BehrensG/ETH1CSMU1/doc/SMU_BOM.xls

Sheet: MBoard
RefDes | Value | Name | Manufacturer | MPN | Qty | $ | $ | Notes
C1, C6, C7 | 47uf 25V | CAPAE_6.6x6.6h5.7 | Panasonic | EEE-1EA470SP | 3 | $0.25 | $0.75
C2, C3, C4, C8, C12, C13, | 4.7u 25V | CAP_0805 |  |  | 6 | $0.10 | $0.60
C9 | 4.7u 25V 4mm |  |  | UWX1E4R7MCL1GB | 1 |  |  | High ESR: Reversed!
C5 | .01 1206 HiV | CAP_1206 |  | C1206X103MCRAC7800 | 1 | $1.00 | $1.00
C10, C18, C19, C20, C25, C27 | 1000p | CAP_0805 |  |  | 6 | $0.05 | $0.30
C11, C14, C15, C16, C17, C21, C22, C23, C24, C29, C30, C31, C32, C33, C35, C36, C37, C43, C44, C45, C46, C47, C49, C50, C52 | .1u 50V | CAP_0805 |  |  | 25 | $0.02 | $0.50
C26, C28, C34 | 15p | CAP_0805 |  |  | 3 | $0.10 | $0.30
C38 | 100p | CAP_0805 |  |  | 1 | $0.10 | $0.10
C39, C40, C41 | 270p COG | CAP_0805 |  |  | 3 | $0.10 | $0.30
C53 C54 | 270p COG 500V | CAP_1206 |  | CL31C271JGFNNNE | 2 | $0.10 | $0.20
C48 | 150p | CAP_0805 |  |  | 1 | $0.10 | $0.10
C51, C42 | 22p 100V | CAP_0805 |  |  | 1 | $0.10 | $0.10
C55 DNI | 22p 500V | CAP_1206 | Yageo | CC1206JRNPOBBN220 | 1 | $0.10 | $0.10
D1, D2 |  | BAV99 100V 215mA SOT23 | ON | BAV99LT1 | 2 | $0.10 | $0.20
D3, D5, D6, D7 |  | BAV199 SOT23 | Nexperia | BAV199.215 | 4 | $0.10 | $0.40
D4 |  | BAV170 SOT23 | Diodes | BAV170Q | 1 | $0.10 | $0.10
J1 | 14 pin box Hdr | HDRF-2x7 | On Shore Technology | 302-S141 (https://www.digikey.com/product-detail/en/on-shore-technology-inc/302-S141/ED10522-ND/2794233) | 1 | $0.50 | $0.50
J2 | 6p .1" Hdr |  | Molex KK | WM2704-ND‎ | 1 | $1.00 | $1.00
J3 | 6p .15" M |  | On Shore Technology | OSTOQ063251 (https://www.digikey.com/product-detail/en/on-shore-technology-inc/OSTOQ063251/ED2812-ND/1588129) | 1 | $1.00 | $1.00
J4 | 3p .15" M |  | On Shore Technology | OSTOQ033251 (https://www.digikey.com/product-detail/en/on-shore-technology-inc/OSTOQ063251/ED2812-ND/1588129) | 1 | $0.50 | $0.50
K2 | 1.5 ohm SW | AQY221R | Panasonic |  | 1 | $4.00 | $4.00 | 100mA range
K3 | 8 ohm SW | TLP170D | Toshiba |  | 1 | $1.50 | $1.50 | 400V 8 ohms
K1 DNI | Low ohm SW |  |  |  | 0 | $1.66 | $0.00 | For 1A range
K6 | .8 ohm SW | CPC1018N | IXYS |  | 1 | $2.00 | $2.00 | For 1.5V range
K4, K5 |  | RELAY2_DPDT | Kemet | EC2-5NU | 2 | $1.50 | $3.00 | 200V 2A DPDT
L1 | 100uH CM Choke | SRF1260A | Bourns | DR331-105 | 1 | $0.80 | $0.80
Q1, Q2 |  | MMBT3904 | Philips-NXP |  | 2 | $0.10 | $0.20
R4, R5, R9, R11, R12, R13, R15, R16, R18, R19, R20, R21, R22, R23, R24, R25, R26, R54 | 10K .1% | RES_0805 |  |  | 18 | $0.10 | $1.80
R51, R52, R53, R55 | 10K .01% | RES_0805 |  |  | 4 | $0.50 | $2.00 | R53-R51 and R55-R52 0.01% matched
R1, R2, R3, R28, R33, R48, R49, R60, R61, R66 | 10K 1% | RES_0805 |  |  | 10 | $0.02 | $0.20
R68 | 10K 1206 | RES_1206 |  |  | 1 | $0.05 | $0.05
R31 | 20K .1% | RES_0805 |  |  | 1 | $0.10 | $0.10
R29, R34 | 20K 1% | RES_0805 |  |  | 2 | $0.02 | $0.04
R10, R14, R17 | 21.5K .1% | RES_0805 |  |  | 3 | $0.02 | $0.06
R64, R6, R8 | 22.1K .1% | RES_0805 |  |  | 3 | $0.02 | $0.06
place holder for increased DAC ranges | 20.5K .1% | RES_0805 |  |  | 0 | $0.02 | $0.00
R7 | 10K DNI | RES_0805 |  |  | 0 | $0.02 | $0.00
R30, R63, R67 | 4.99K 1% | RES_0805 |  |  | 3 | $0.02 | $0.06
R44 | 4.99K .1% | RES_0805 |  |  | 1 | $0.20 | $0.20
R35 | 200K 1206 | RES_0805 |  |  | 1 | $0.05 | $0.05
R27, R36, R37, R57, R62, R69, R70 | 2K 1% | RES_0805 |  |  | 7 | $0.02 | $0.14
R38, R39 | 2 ohm 1W (DNI) | RES_2512 |  |  | 0 | $0.40 | $0.00
R40, R41 | 100 .1% 1W | RES_2512 |  | RNCF2512TKY100R | 2 | $2.00 | $4.00 | 5ppm .01%
R42 | 499 .1% .25W | RES_1206 |  |  | 1 | $0.50 | $0.50
R43 | 5M 25ppm 1206 | RG3216P-5004-B-T1 (https://www.digikey.com/product-detail/en/susumu/RG3216P-5004-B-T1/408-2038-1-ND/7035421) | Susumu |  | 1 | $0.60 | $0.60
R45 | 49.9K .1% | RES_0805 |  |  | 1 | $0.20 | $0.20
R46 | 549K .1% | RES_0805 |  |  | 1 | $0.20 | $0.20 | 562K is OK
R47, R50, R56, R59 | 100K .1% | RES_0805 |  |  | 4 | $0.10 | $0.40
R58 | 1K | RES_0805 |  |  | 1 | $0.02 | $0.02
R65 | 301K .1% 1206 | RES_1206 |  |  | 1 | $0.40 | $0.40
TP1, TP2, TP3, TP4, TP5 | DNI | TESTPOINT |  |  | 5 | $0.00 | $0.00
U1 | DPBW03F | 3W_DC-DC | MeanWell | DPBW03F | 1 | $10.00 | $10.00
U2 | LM1117 5V | SOT223 | ON Semi | NCP1117LPST50T3G | 1 | $0.50 | $0.50 | many other 1117's
U3 | Si8661AB | Si8661AB-B-IS1 | Silicon Labs | Si8661BB | 1 | $2.50 | $2.50 | Watch default state
U4 |  | TLC2272A | TI | TLC2272AIDR | 1 | $1.50 | $1.50
U5 |  | ADR431BRZ | Analog Devices | ADR431BRZ | 1 | $9.50 | $9.50 | 3ppm, .04%
U6 |  | AT25160B_SOIC8 | Atmel | AT25160B_SOIC8 | 0 | $0.50 | $0.00 | Option…
U7 |  | TL072ACD | TI | TL072ACD | 1 | $0.50 | $0.50
U8, U13, U12, U14, U19, U21 |  | OPA2140 | TI | OPA2140 | 6 | $4.40 | $26.40
U9 | Quad 16b dac | AD5686RBRUZ | Analog Devices | AD5686RBRUZ | 1 | $16.00 | $16.00
U10 | S-D ADC | AD7190BRUZ | Analog Devices | AD7190BRUZ | 1 | $10.00 | $10.00
U11, U17, U18 |  | DG444 or DG441DY | AD, Maxim, Renesas | DG444 or DG441DY | 3 | $2.00 | $6.00 | DG441 has no VL
U15, U16 |  | 74HC595D | NXP-Philips | 74HC595D | 2 | $0.60 | $1.20
U20 |  | TL071ACD | TI | TL071ACD | 1 | $0.50 | $0.50
U22, U23 | Single, Low Ib | OPA140 | TI | OPA140 | 2 | $3.00 | $6.00
PCB |  | 3.5 x 8" |  |  | 1 | $10.00 | $10.00
Total |  |  |  |  |  |  | $131.23

Sheet: Amp Board
RefDes | Value | Name | Manufacturer | MPN | Quantity | $ | $ | Notes
C1, C2 | 470UF 200V | .4" LS 1" dia. | Rubycon | 250MXG470MEFCSN25X30 | 2 | $3.50 | $7.00
C3, C5 | 1U 250V film .45 spacing | CAP300 | Pan | ECQ-E2105KB (https://www.digikey.com/product-detail/en/panasonic-electronic-components/ECQ-E2105KB/P10979-ND/295886) | 2 | $1.00 | $2.00 | Wrong lead spacing
C4, C6 | 470U 25V | CAPAE_8.35x8.35h6.2 |  | EMZS250ARA471MHA0G | 2 | $0.70 | $1.40
C8, C9, C10, C11 | 1000p 500V | CAP_1206 |  | CL31B102KGFNFNE | 4 | $0.15 | $0.60
C7, C12 | 2200p 500V | CAP_1206 | Samsung | CL31B222KGFNFNE | 2 | $0.15 | $0.30
D1, D2, D3, D4, D17, D18 |  | 1N4007 |  |  | 6 | $0.10 | $0.60
D5, D6, D9, D10, D11, D12 |  | BAV99LT1 | ON |  | 6 | $0.10 | $0.60
D7, D8 | 15V 5% 1W Zener | 1N4744A |  |  | 2 | $0.15 | $0.30
D9, D10 | LED Red, 5mm TH |  | Lite-On | LTL4223 | 2 | $0.20 | $0.40
J1 | 5.08mm header 5pos |  | OST | OSTOQ055451 OSTOQ055450 | 1 | $1.00 | $1.00 | RA Vertical
J2 | 3.81mm screw terminal, 6pos |  | OST | OSTOQ063251 (https://www.digikey.com/product-detail/en/on-shore-technology-inc/OSTOQ063251/ED2812-ND/1588129) | 1 | $1.00 | $1.00
J3 | 6pos KK Vert male | HDR-1x6 |  | WM2704-ND‎ | 1 | $1.00 | $1.00
Q1, Q2 | N-Fet 200V 5A TO220 | IRL620 | IR | MMBT3904 | 2 | $0.90 | $1.80 | 200V 5A .8ohm 350pF
Q3 | NPN 120V TO220 | TIP41C | ON | MMBT3906 | 1 | $0.60 | $0.60
Q4 | PNP 120V TO220 | TIP42C | ON | PZT2222 | 1 | $0.60 | $0.60
Q5, Q6 | P-Fet 200V 3.5A TO220 | IRF9620 | IR | PZT2907 | 2 | $0.90 | $1.80 | 200V 3.5A 1.5ohm 350pF
Q7 | NPN 40V SOT23 | MMBT3904 |  | MMBT3904 | 1 | $0.10 | $0.10
Q8 | PNP 40V SOT23 | MMBT3906 |  | MMBT3906 | 1 | $0.10 | $0.10
Q9 | NPN 40V SOT223 | PZT2222 |  | PZT2222 | 1 | $0.30 | $0.30
Q10 | PNP 40V SOT223 | PZT2907 |  | PZT2907 | 1 | $0.30 | $0.30
R1, R2 | 30.1 Ohm 5% .5W 1206 | RES_1206 | Yageo | RC1206JR-0730RL | 2 | $0.10 | $0.20
R3, R4, R6, R8 | 2.2M 1206 | RES_1206 | Yageo |  | 4 | $0.10 | $0.40
R5, R7 | 1M 1206 | RES_1206 | Yageo |  | 2 | $0.10 | $0.20
R9, R16 | 25 1W 2512 | RES_2512 | Yageo |  | 2 | $0.10 | $0.20
R10 | 24.9 1% | RES_0805 | Yageo |  | 1 | $0.05 | $0.05
R11, R13 | 1k | RES_0805 | Yageo |  | 2 | $0.05 | $0.10
R12, R17, R19 | 249 1% | RES_0805 | Yageo |  | 2 | $0.05 | $0.10
R20, R21, R22, R23 | 49.9 ohm 1% | RES_0805 | Yageo |  | 4 | $0.05 | $0.20
R18, R32 | 2K 1% 1W 2512 | RES_2512 | Yageo |  | 2 | $0.10 | $0.20
R14, R15 | 1K 5% 1W 2512 | RES_2512 |  |  | 2 | $0.30 | $0.60
PCB Amp Rev2 |  | 7.25 x 1.9" 184.15 x 48.26mm |  |  | 1 | $5.00 | $5.00
 |  |  |  |  |  |  | $29.05

Sheet: System
RefDes | Value | Manufacturer | MPN | Quantity | $ | $ | Notes
T1 | 120V x 2 Med Grade 25-50W Transformer | Talema Triad | 0050MD-1-003 VPM240-100 | 1 | $35.00 | $35.00
HS1 | Heat Sink ~2.5 x 7 x .25" |  |  | 1 | $10.00 | $10.00 | Approx cost. 6 tapped holes
 | TO220 Thermal pads | Chomerics | 60-11-D397-1674 | 6 | $0.50 | $3.00
 | #4 shoulder washers | Keystone | 3102 | 6 | $0.25 | $1.50
 | $4-40 screws, 3/8" SS |  |  | 6 | $0.10 | $0.60
HW | Standoffs… |  |  | 10 | $0.30 | $3.00
Connectors | 5.08mm Term Block Plug 5pos | OST | OSTTJ055153 | 1 | $2.00 | $2.00
 | 3.81 plug screw 3pos | Amphenol | TJ0331530000G | 1 | $0.80 | $0.80
 | 3.81 plug screw 6pos | Amphenol | TJ0631530000G | 2 | $1.20 | $2.40
 | .1" KK 6pos, gold pins | Molex | WM2312-ND | 10 | $0.15 | $1.50
Banana Jacks | Black, Safety type | Cal Test | CT29xx | 2 | $1.50 | $3.00 | - and -sense
Banana Jacks | Red, Safety type | Cal Test | CT29xx | 2 | $1.50 | $3.00 | + and +sense
Banana Jacks | Yellow, Safety type | Cal Test | CT29xx | 1 | $1.50 | $1.50 | Guard
Banana Jacks | Green, Safety type | Cal Test | CT29xx | 1 | $1.50 | $1.50 | Ground
12V 1A PS | 12V Enclosed power supply | MeanWell TDK | RS-15-12 LS25-12 | 1 | $16.00 | $16.00 | Meanwell is cheaper TDK lower noise, $$$
AC In | AC in with fuse, switch and filter | Delta | 06AK2 | 1 | $18.00 | $18.00
AC SW |  |  |  | 1 | $2.00 | $2.00
Enclosure |  |  |  | 1 | $45.00 | $45.00
Fan | 50mm 12V |  |  | 1 | $5.00 | $5.00
Main Board |  |  |  | 1 | $131.23 | $131.23
Amp Board |  |  |  | 1 | $29.05 | $29.05
FP Board | FP Board, Teensy 3.2, TFT, buttons |  |  | 1 | $60.00 | $60.00
Front Panel | PCB? |  |  | 1 | $10.00 | $10.00
Total |  |  |  |  |  | $385.08
