BehrensG/ETH1CSMU1/doc/AmpBoardSch1.pdf

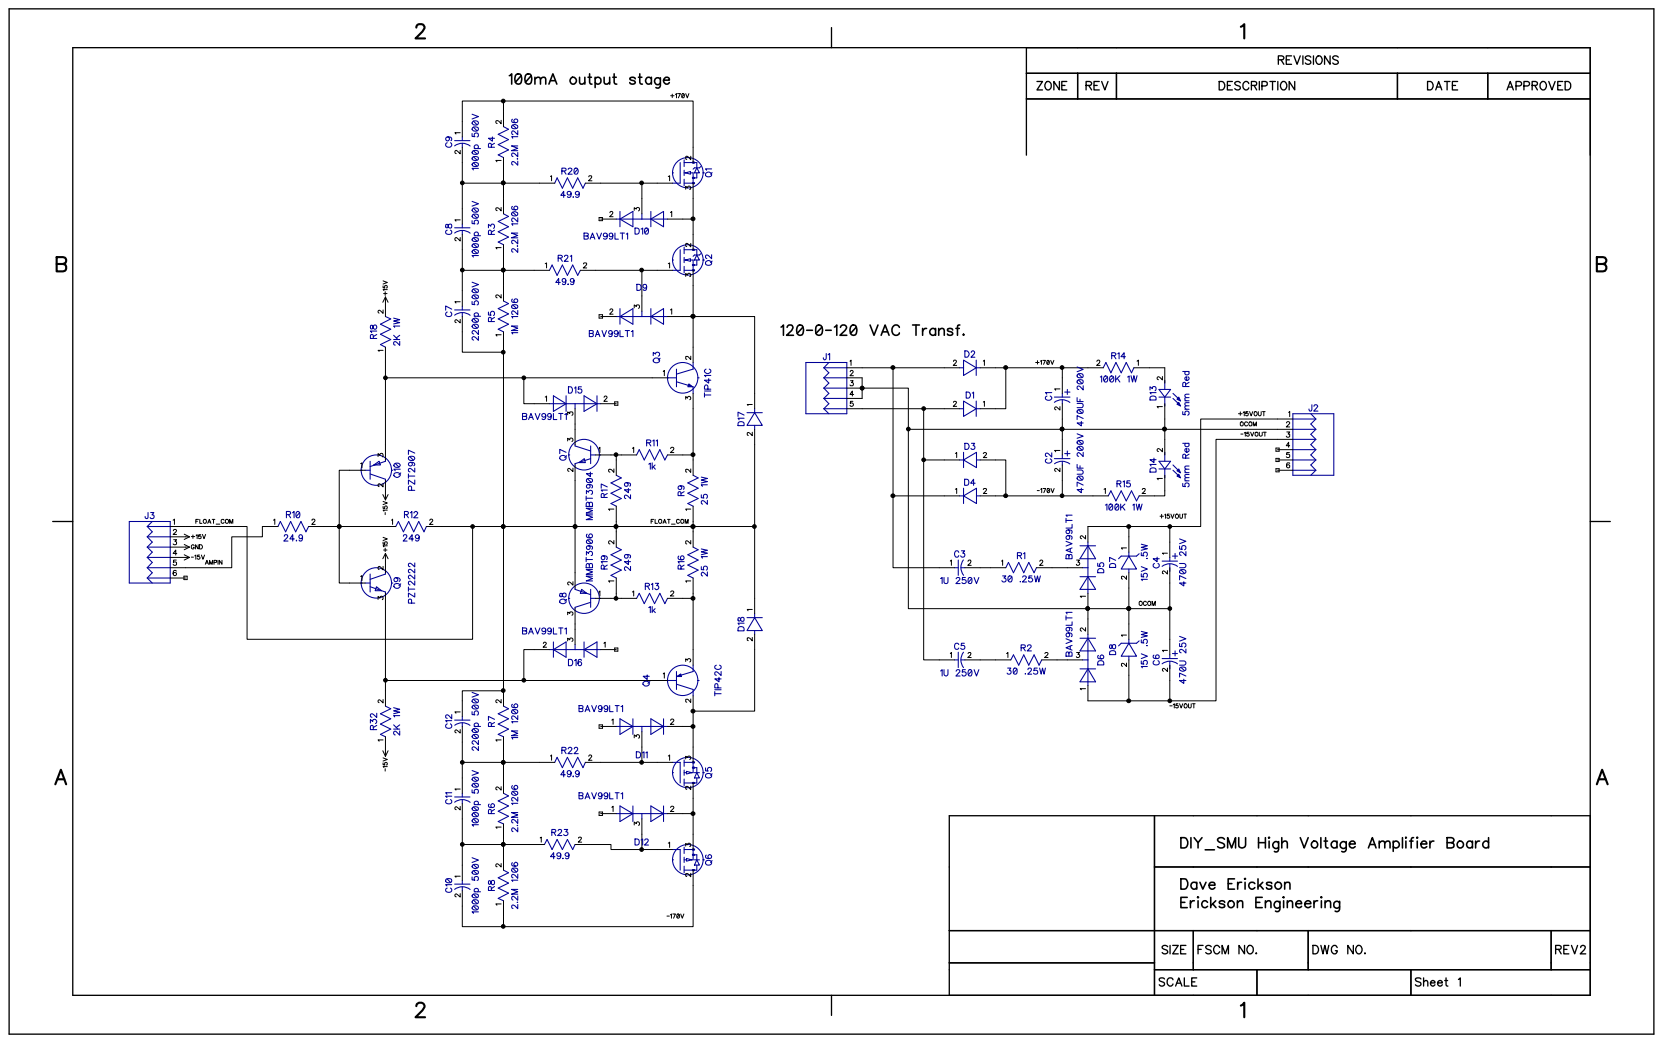
[picture p1: page 1]
