BehrensG/ETH1CSMU1/doc/MainBoardSch1.pdf

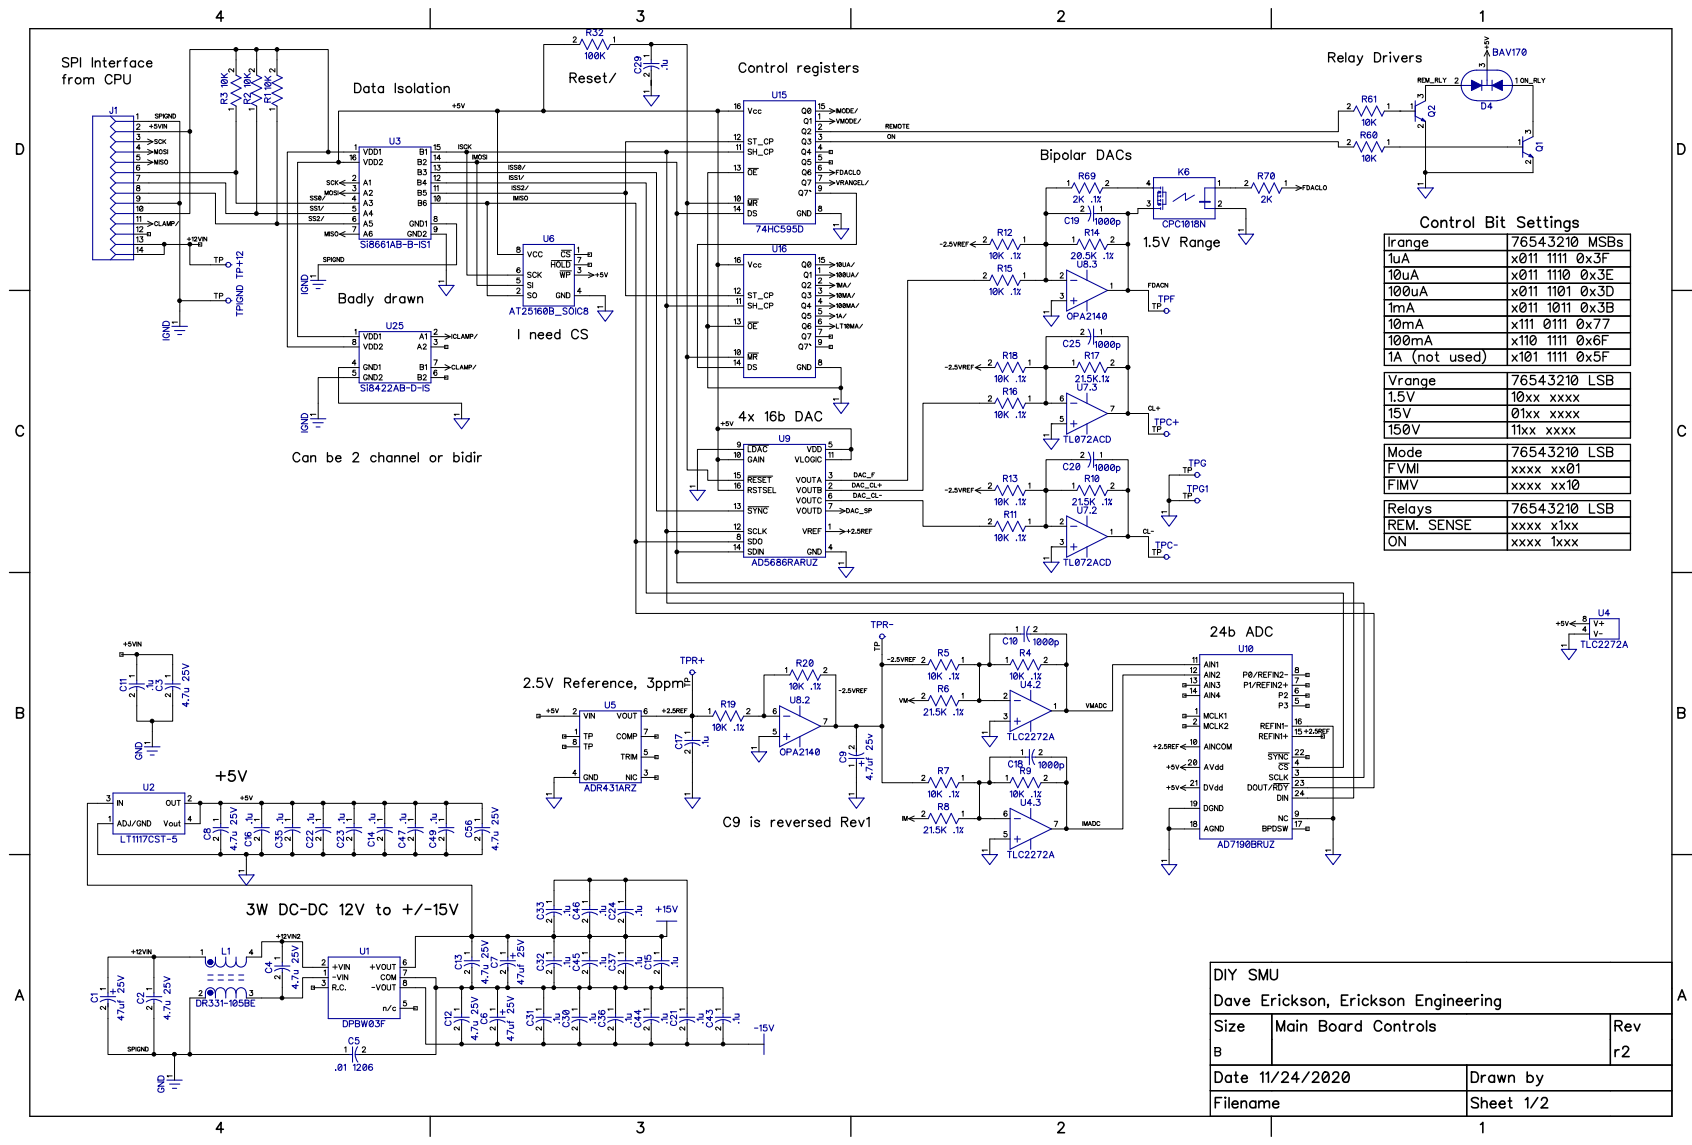
[picture p2: page 1]

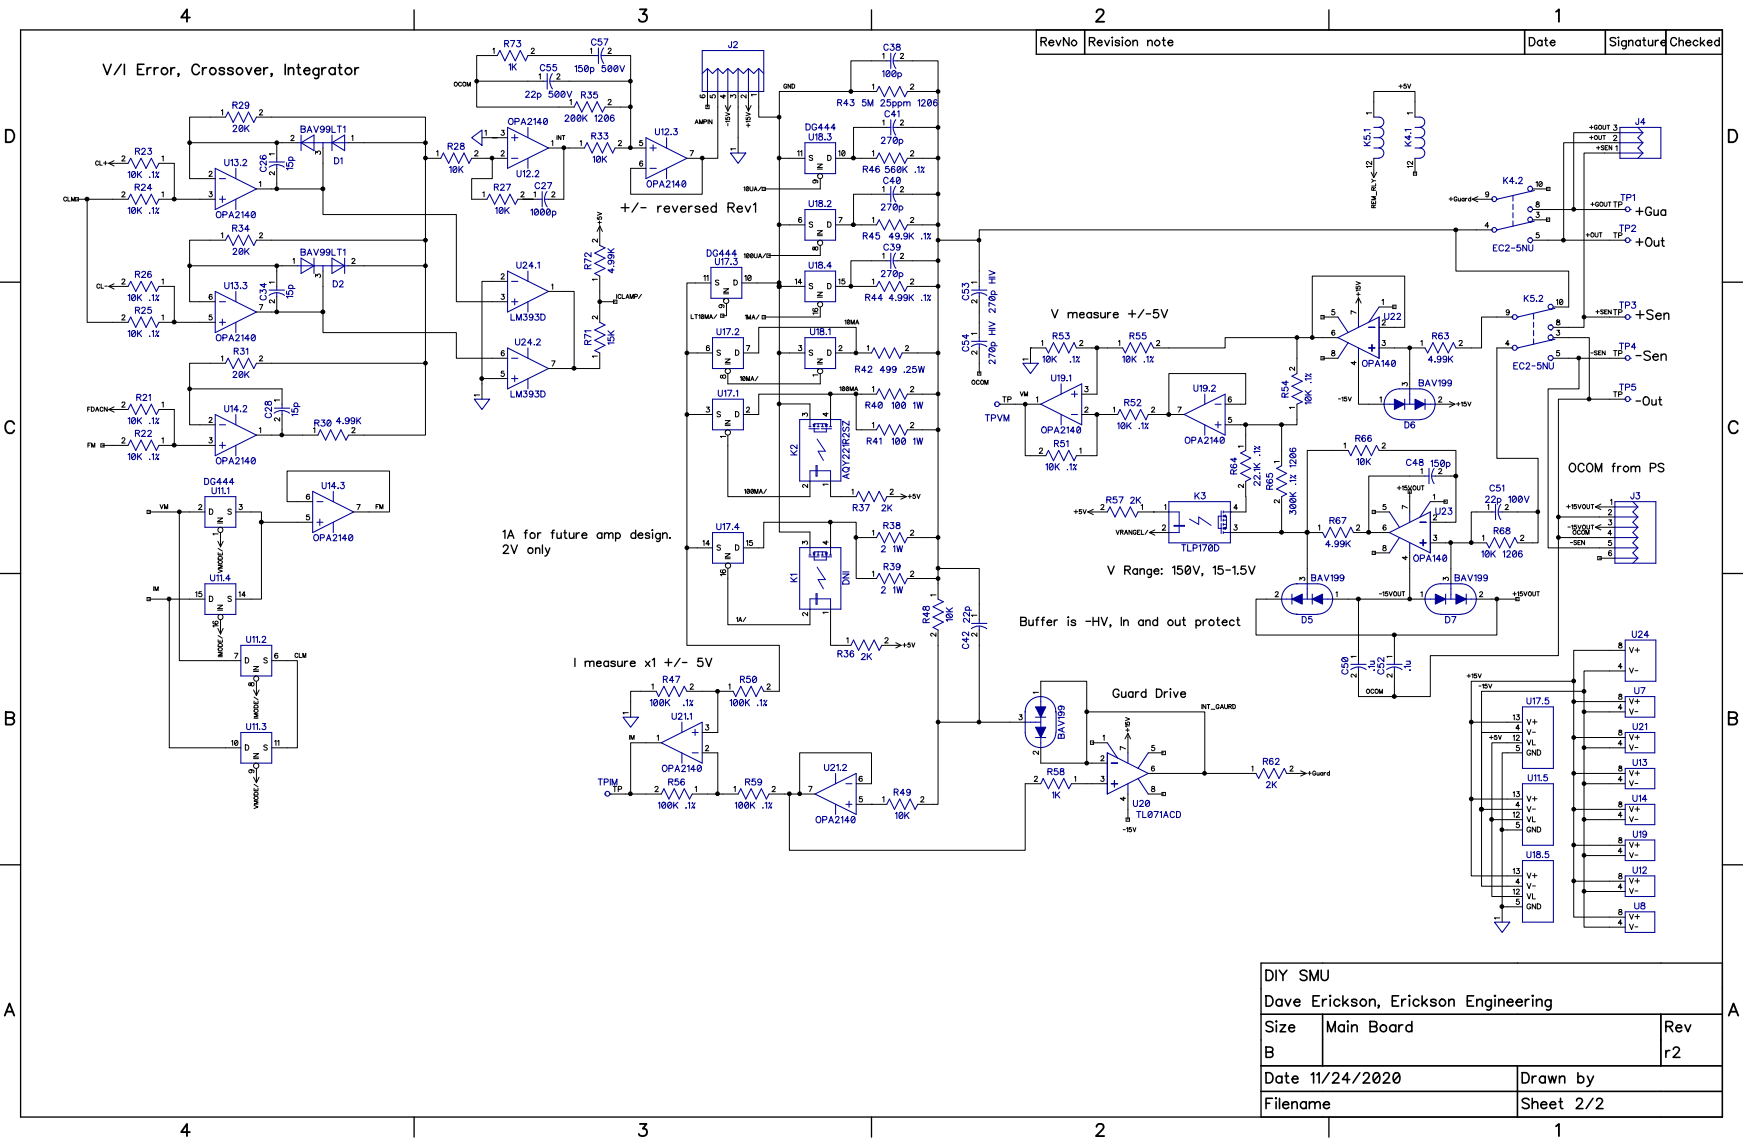
[picture p3: page 2]
