BehrensG/ETH1CSMU1/HARDWARE/MODULE/MODULE.kicad_pcb

## KiCad design HARDWARE/MODULE/MODULE.kicad_pcb (2021-06-25)

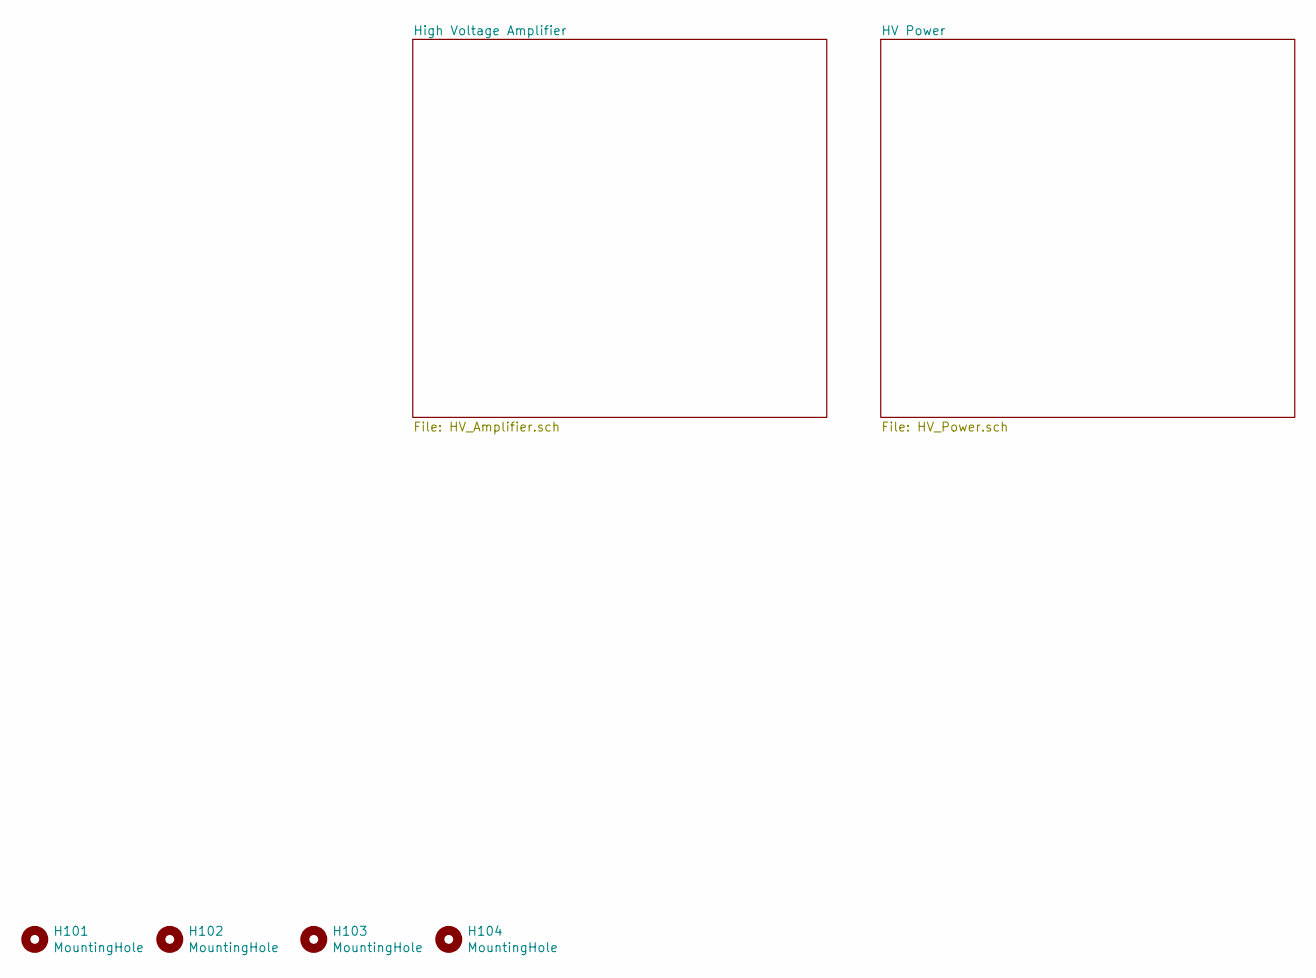
[picture p4: schematic MODULE.sch]

Parts:
H101, H102, H103, H104: MountingHole; MountingHole_3.2mm_M3_DIN965_Pad

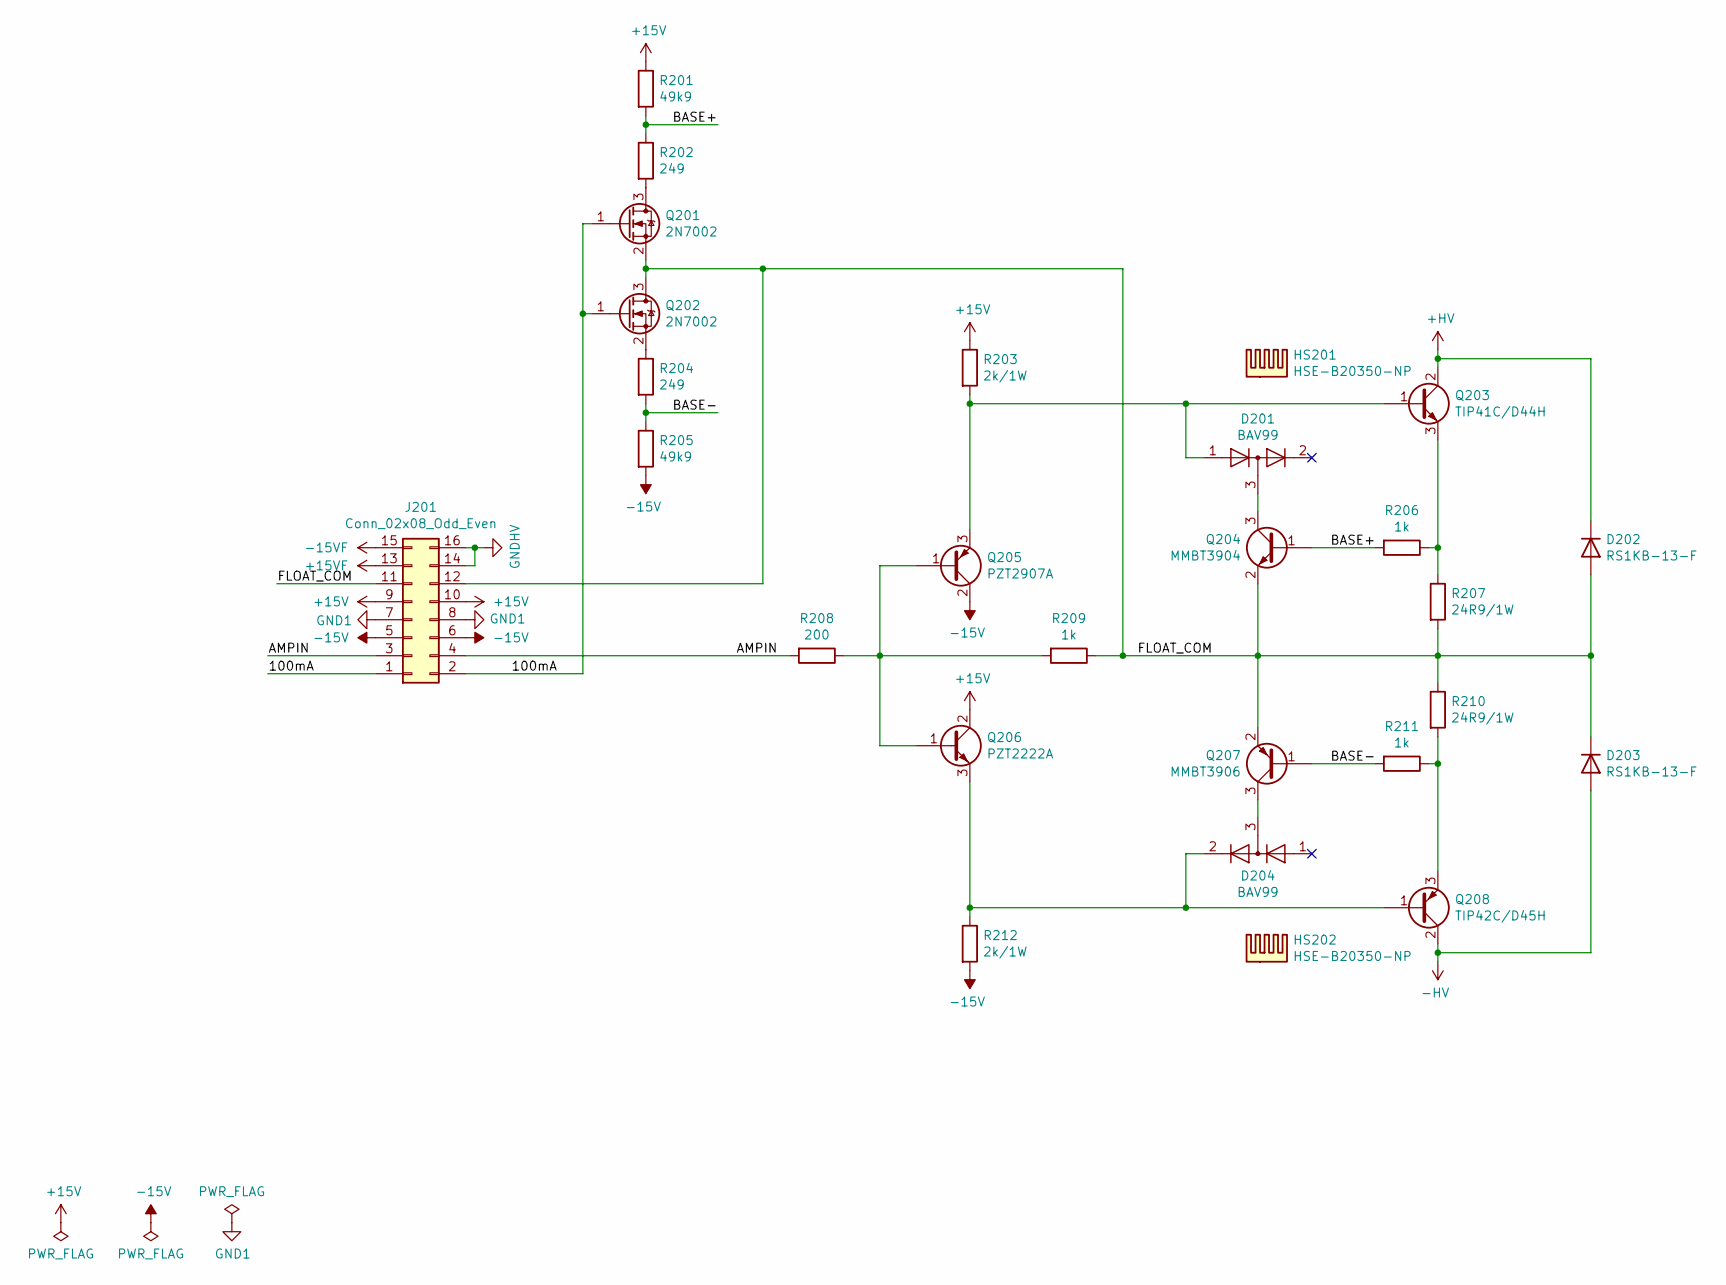
[picture p5: schematic HV_Amplifier.sch]

Parts:
D201, D204: BAV99; SOT-23
D202, D203: RS1KB-13-F; D_SMA
HS201, HS202: HSE-B20350-NP
J201: Conn_02x08_Odd_Even; PinSocket_2x08_P2.54mm_Vertical
Q201, Q202: 2N7002; SOT-23
Q203: TIP41C/D44H; TO-220-3_Horizontal_TabDown
Q204: MMBT3904; SOT-23
Q205: PZT2907A; SOT-223-3_TabPin2
Q206: PZT2222A; SOT-223-3_TabPin2
Q207: MMBT3906; SOT-23
Q208: TIP42C/D45H; TO-220-3_Horizontal_TabDown
R201, R205: 49k9; R_0805_2012Metric_Pad1.20x1.40mm_HandSolder
R202, R204: 249; R_0805_2012Metric_Pad1.20x1.40mm_HandSolder
R203, R212: 2k/1W; R_2512_6332Metric_Pad1.40x3.35mm_HandSolder
R206, R209, R211: 1k; R_0805_2012Metric_Pad1.20x1.40mm_HandSolder
R207, R210: 24R9/1W; R_2512_6332Metric_Pad1.40x3.35mm_HandSolder
R208: 200; R_0805_2012Metric_Pad1.20x1.40mm_HandSolder

Connections:
+15V: J201.9, J201.10, Q206.2 (C), R201.1, R203.1
+15VF: J201.13; also elsewhere on the board
+HV: D202.1 (K), Q203.2 (C); also elsewhere on the board
-15V: J201.5, J201.6, Q205.2 (C), R205.2, R212.2
-15VF: J201.15; also elsewhere on the board
-HV: D203.2 (A), Q208.2 (C); also elsewhere on the board
/High Voltage Amplifier/100mA: J201.1, J201.2, Q201.1 (G), Q202.1 (G)
/High Voltage Amplifier/AMPIN: J201.3, J201.4, R208.2
/High Voltage Amplifier/BASE+: Q204.1 (B), R201.2, R202.1, R206.2
/High Voltage Amplifier/BASE-: Q207.1 (B), R204.2, R205.1, R211.2
/High Voltage Amplifier/FLOAT_COM: D202.2 (A), D203.1 (K), J201.11, J201.12, Q201.2 (S), Q202.3 (D), Q204.2 (E), Q207.2 (E), R207.2, R209.1, R210.1
GND1: J201.7, J201.8
GNDHV: J201.14, J201.16; also elsewhere on the board
unnamed: D201.1 (K), Q203.1 (B), Q205.3 (E), R203.2
unnamed: D201.3 (K), Q204.3 (C)
unnamed: D204.2 (A), Q206.3 (E), Q208.1 (B), R212.1
unnamed: D204.3 (K), Q207.3 (C)
unnamed: Q201.3 (D), R202.2
unnamed: Q202.2 (S), R204.1
unnamed: Q203.3 (E), R206.1, R207.1
unnamed: Q205.1 (B), Q206.1 (B), R208.1, R209.2
unnamed: Q208.3 (E), R210.2, R211.1

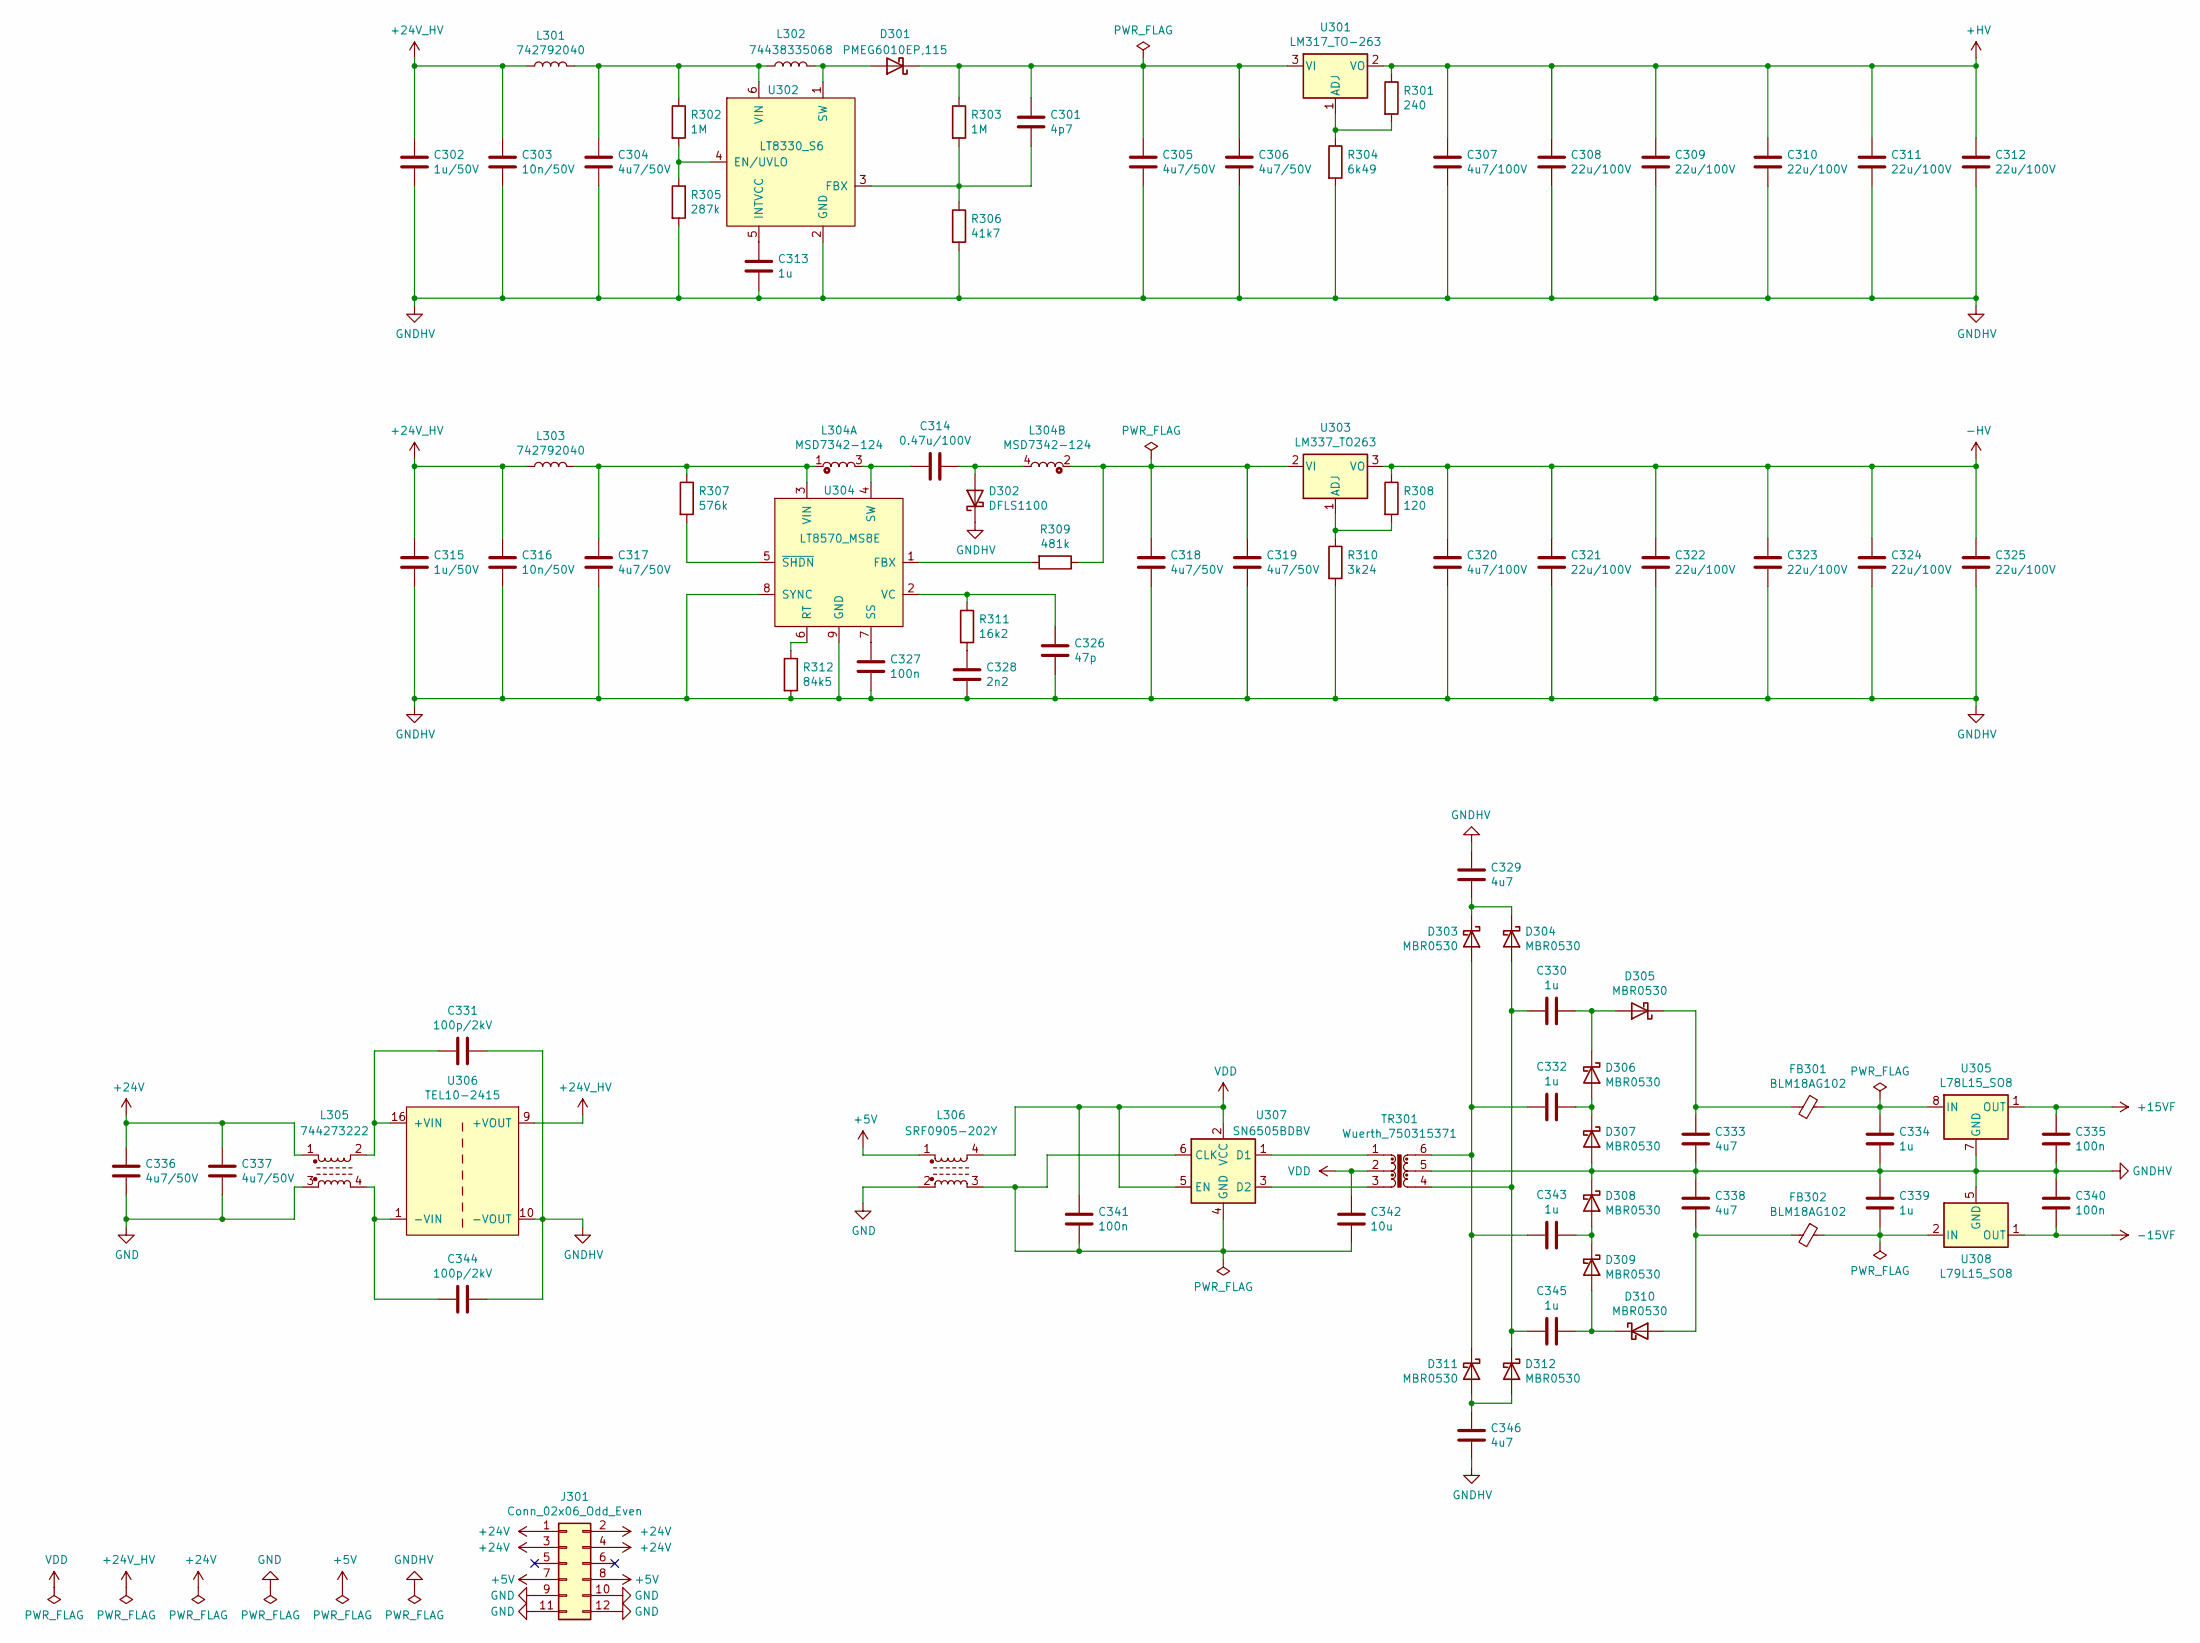
[picture p6: schematic HV_Power.sch]

Parts:
C301: 4p7; C_0603_1608Metric_Pad1.08x0.95mm_HandSolder
C302, C315: 1u/50V; C_1206_3216Metric_Pad1.33x1.80mm_HandSolder
C303, C316: 10n/50V; C_1206_3216Metric_Pad1.33x1.80mm_HandSolder
C304, C305, C306, C317, C318, C319, C336, C337: 4u7/50V; C_1206_3216Metric_Pad1.33x1.80mm_HandSolder
C307, C320: 4u7/100V; C_2220_5650Metric_Pad1.97x5.40mm_HandSolder
C308, C309, C310, C311, C312, C321, C322, C323, C324, C325: 22u/100V; C_2220_5650Metric_Pad1.97x5.40mm_HandSolder
C313, C330, C332, C334, C339, C343, C345: 1u; C_0603_1608Metric_Pad1.08x0.95mm_HandSolder
C314: 0.47u/100V; C_1206_3216Metric_Pad1.33x1.80mm_HandSolder
C326: 47p; C_0603_1608Metric_Pad1.08x0.95mm_HandSolder
C327, C335, C340, C341: 100n; C_0603_1608Metric_Pad1.08x0.95mm_HandSolder
C328: 2n2; C_0603_1608Metric_Pad1.08x0.95mm_HandSolder
C329, C333, C338, C346: 4u7; C_0603_1608Metric_Pad1.08x0.95mm_HandSolder
C331, C344: 100p/2kV; C_1210_3225Metric_Pad1.33x2.70mm_HandSolder
C342: 10u; C_0603_1608Metric_Pad1.08x0.95mm_HandSolder
D301: PMEG6010EP,115; D_SOD-128
D302: DFLS1100; PowerDI-123
D303, D304, D305, D306, D307, D308, D309, D310, D311, D312: MBR0530; D_SOD-123
FB301, FB302: BLM18AG102; L_0603_1608Metric_Pad1.05x0.95mm_HandSolder
J301: Conn_02x06_Odd_Even; PinSocket_2x06_P2.54mm_Vertical
L301, L303: 742792040; L_0805_2012Metric_Pad1.15x1.40mm_HandSolder
L302: 74438335068
L304: MSD7342-124; MSD7342
L305: 744273222
L306: SRF0905-202Y; SRF0905
R301: 240; R_0603_1608Metric_Pad0.98x0.95mm_HandSolder
R302, R303: 1M; R_0603_1608Metric_Pad0.98x0.95mm_HandSolder
R304: 6k49; R_0603_1608Metric_Pad0.98x0.95mm_HandSolder
R305: 287k; R_0603_1608Metric_Pad0.98x0.95mm_HandSolder
R306: 41k7; R_0603_1608Metric_Pad0.98x0.95mm_HandSolder
R307: 576k; R_0603_1608Metric_Pad0.98x0.95mm_HandSolder
R308: 120; R_0603_1608Metric_Pad0.98x0.95mm_HandSolder
R309: 481k; R_0603_1608Metric_Pad0.98x0.95mm_HandSolder
R310: 3k24; R_0603_1608Metric_Pad0.98x0.95mm_HandSolder
R311: 16k2; R_0603_1608Metric_Pad0.98x0.95mm_HandSolder
R312: 84k5; R_0603_1608Metric_Pad0.98x0.95mm_HandSolder
TR301: Wuerth_750315371; Transformer_Wuerth_750315371
U301: LM317_TO-263; TO-263-3_TabPin2
U302: LT8330_S6; TSOT-23-6_HandSoldering
U303: LM337_TO263; TO-263-3_TabPin2
U304: LT8570_MS8E; MSOP-8-1EP_3x3mm_P0.65mm_EP1.68x1.88mm_ThermalVias
U305: L78L15_SO8; SOIC-8_3.9x4.9mm_P1.27mm
U306: TEL10-2415; TEL10
U307: SN6505BDBV; SOT-23-6
U308: L79L15_SO8; SOIC-8_3.9x4.9mm_P1.27mm

Connections:
+5V: J301.7, J301.8, L306.1
+15VF: C335.1, U305.1 (OUT); also elsewhere on the board
+24V: C336.1, C337.1, J301.1, J301.2, J301.3, J301.4, L305.1
+24V_HV: C302.1, C303.1, C315.1, C316.1, L301.1, L303.1, U306.9 (+VOUT)
+HV: C307.1, C308.1, C309.1, C310.1, C311.1, C312.1, R301.1, U301.2 (VO); also elsewhere on the board
-15VF: C340.2, U308.1 (OUT); also elsewhere on the board
-HV: C320.1, C321.1, C322.1, C323.1, C324.1, C325.1, R308.1, U303.3 (VO); also elsewhere on the board
GND: C336.2, C337.2, J301.9, J301.10, J301.11, J301.12, L305.3, L306.2
GNDHV: C302.2, C303.2, C304.2, C305.2, C306.2, C307.2, C308.2, C309.2, C310.2, C311.2, C312.2, C313.2, C315.2, C316.2, C317.2, C318.2, C319.2, C320.2, C321.2, C322.2, C323.2, C324.2, C325.2, C326.2, C327.2, C328.2, C329.1, C331.1, C333.2, C334.2, C335.2, C338.1, C339.1, C340.1, C344.1, C346.2, D302.1 (K), D307.2 (A), D308.1 (K), R304.2, R305.2, R306.2, R310.2, R312.2, TR301.5, U302.2 (GND), U304.8 (SYNC), U304.9 (GND), U305.2 (GND), U305.3 (GND), U305.6 (GND), U305.7 (GND), U306.10 (-VOUT), U308.5 (GND); also elsewhere on the board
unnamed: C301.1, C305.1, C306.1, D301.1 (K), R303.1, U301.3 (VI)
unnamed: C301.2, R303.2, R306.1, U302.3 (FBX)
unnamed: C304.1, L301.2, L302.1, R302.1, U302.6 (VIN)
unnamed: C313.1, U302.5 (INTVCC)
unnamed: C314.1, D302.2 (A), L304.4
unnamed: C314.2, L304.3, U304.4 (SW)
unnamed: C317.1, L303.2, L304.1, R307.1, U304.3 (VIN)
unnamed: C318.1, C319.1, L304.2, R309.1, U303.2 (VI)
unnamed: C326.1, R311.1, U304.2 (VC)
unnamed: C327.1, U304.7 (SS)
unnamed: C328.1, R311.2
unnamed: C329.2, D303.1 (K), D304.1 (K)
unnamed: C330.1, D305.2 (A), D306.1 (K)
unnamed: C330.2, C345.2, D304.2 (A), D312.1 (K), TR301.4
unnamed: C331.2, L305.2, U306.16 (+VIN)
unnamed: C332.1, D306.2 (A), D307.1 (K)
unnamed: C332.2, C343.2, D303.2 (A), D311.1 (K), TR301.6
unnamed: C333.1, D305.1 (K), FB301.2
unnamed: C334.1, FB301.1, U305.8 (IN)
unnamed: C338.2, D310.2 (A), FB302.2
unnamed: C339.2, FB302.1, U308.2 (IN), U308.3 (IN), U308.6 (IN), U308.7 (IN)
unnamed: C341.2, C342.2, L306.3, U307.4 (GND), U307.6 (CLK)
unnamed: C343.1, D308.2 (A), D309.1 (K)
unnamed: C344.2, L305.4, U306.1 (-VIN)
unnamed: C345.1, D309.2 (A), D310.1 (K)
unnamed: C346.1, D311.2 (A), D312.2 (A)
unnamed: D301.2 (A), L302.2, U302.1 (SW)
unnamed: R301.2, R304.1, U301.1 (ADJ)
unnamed: R302.2, R305.1, U302.4 (EN/UVLO)
unnamed: R307.2, U304.5 (~SHDN)
unnamed: R308.2, R310.1, U303.1 (ADJ)
unnamed: R309.2, U304.1 (FBX)
unnamed: R312.1, U304.6 (RT)
unnamed: TR301.1, U307.1 (D1)
unnamed: TR301.3, U307.3 (D2)
VDD: C341.1, C342.1, L306.4, TR301.2, U307.2 (VCC), U307.5 (EN)

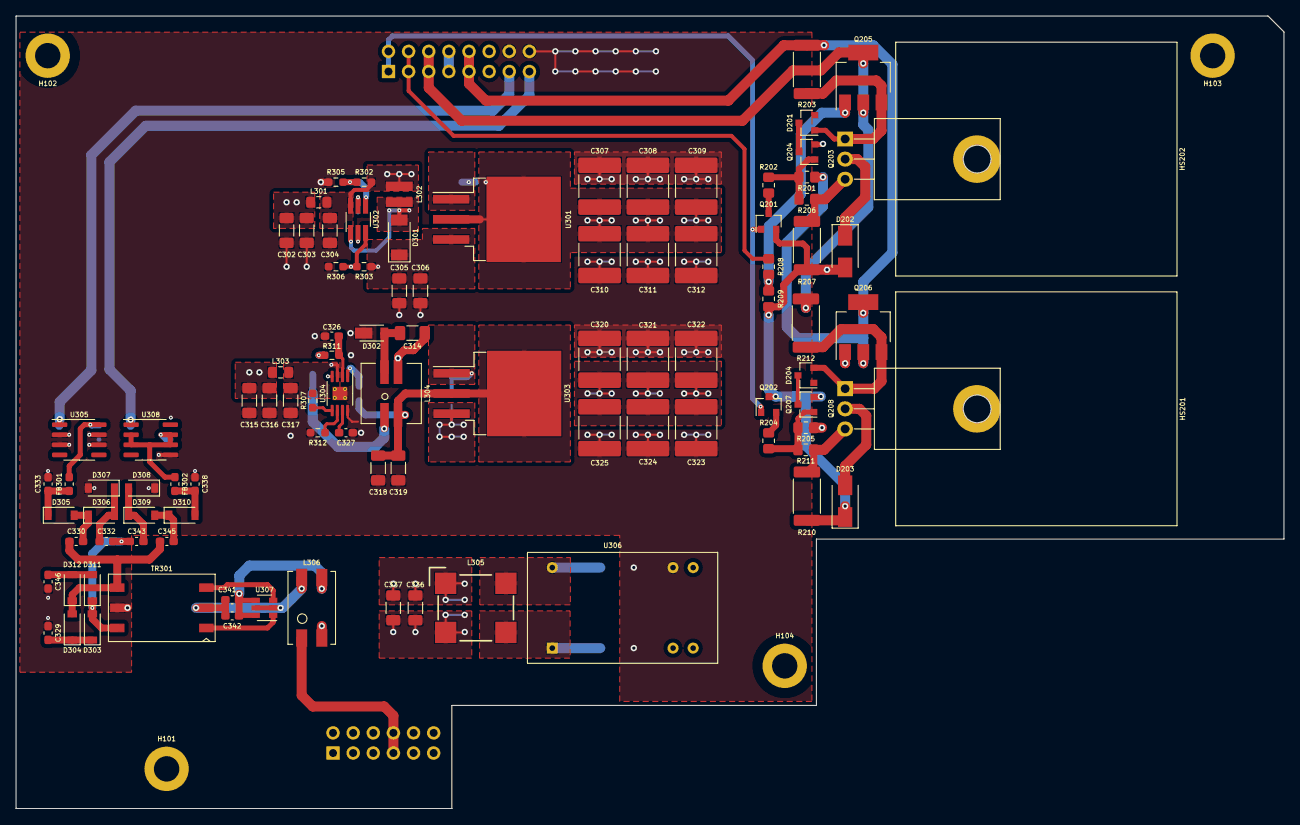
[picture p7: board MODULE.kicad_pcb from above]

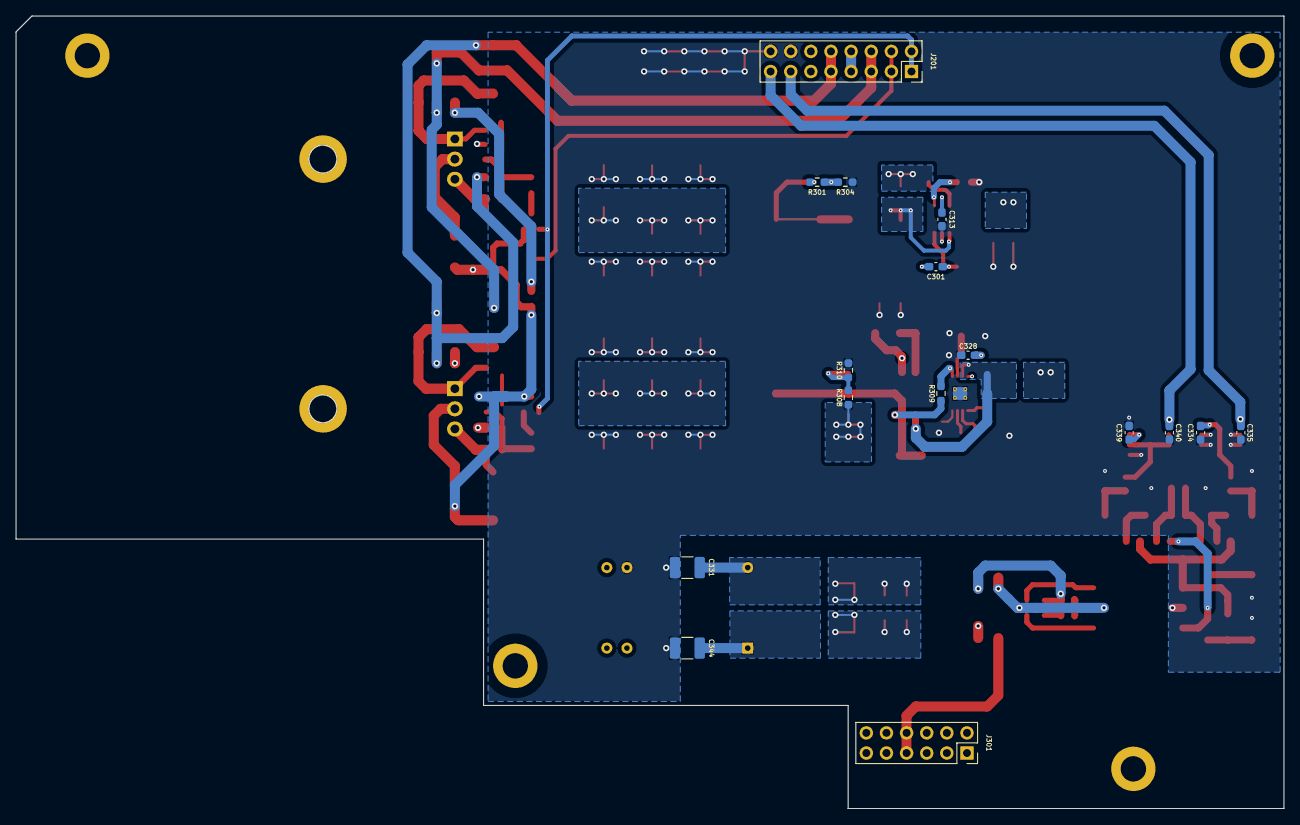
[picture p8: board MODULE.kicad_pcb from below]

Board: 4 copper layers, 160.0 x 100.0 mm, 119 parts (16 on the bottom side), 62 nets.
