BehrensG/ETH1CSMU1/HARDWARE/BASE/BASE.kicad_pcb

## KiCad design HARDWARE/BASE/BASE.kicad_pcb (2021-04-07)

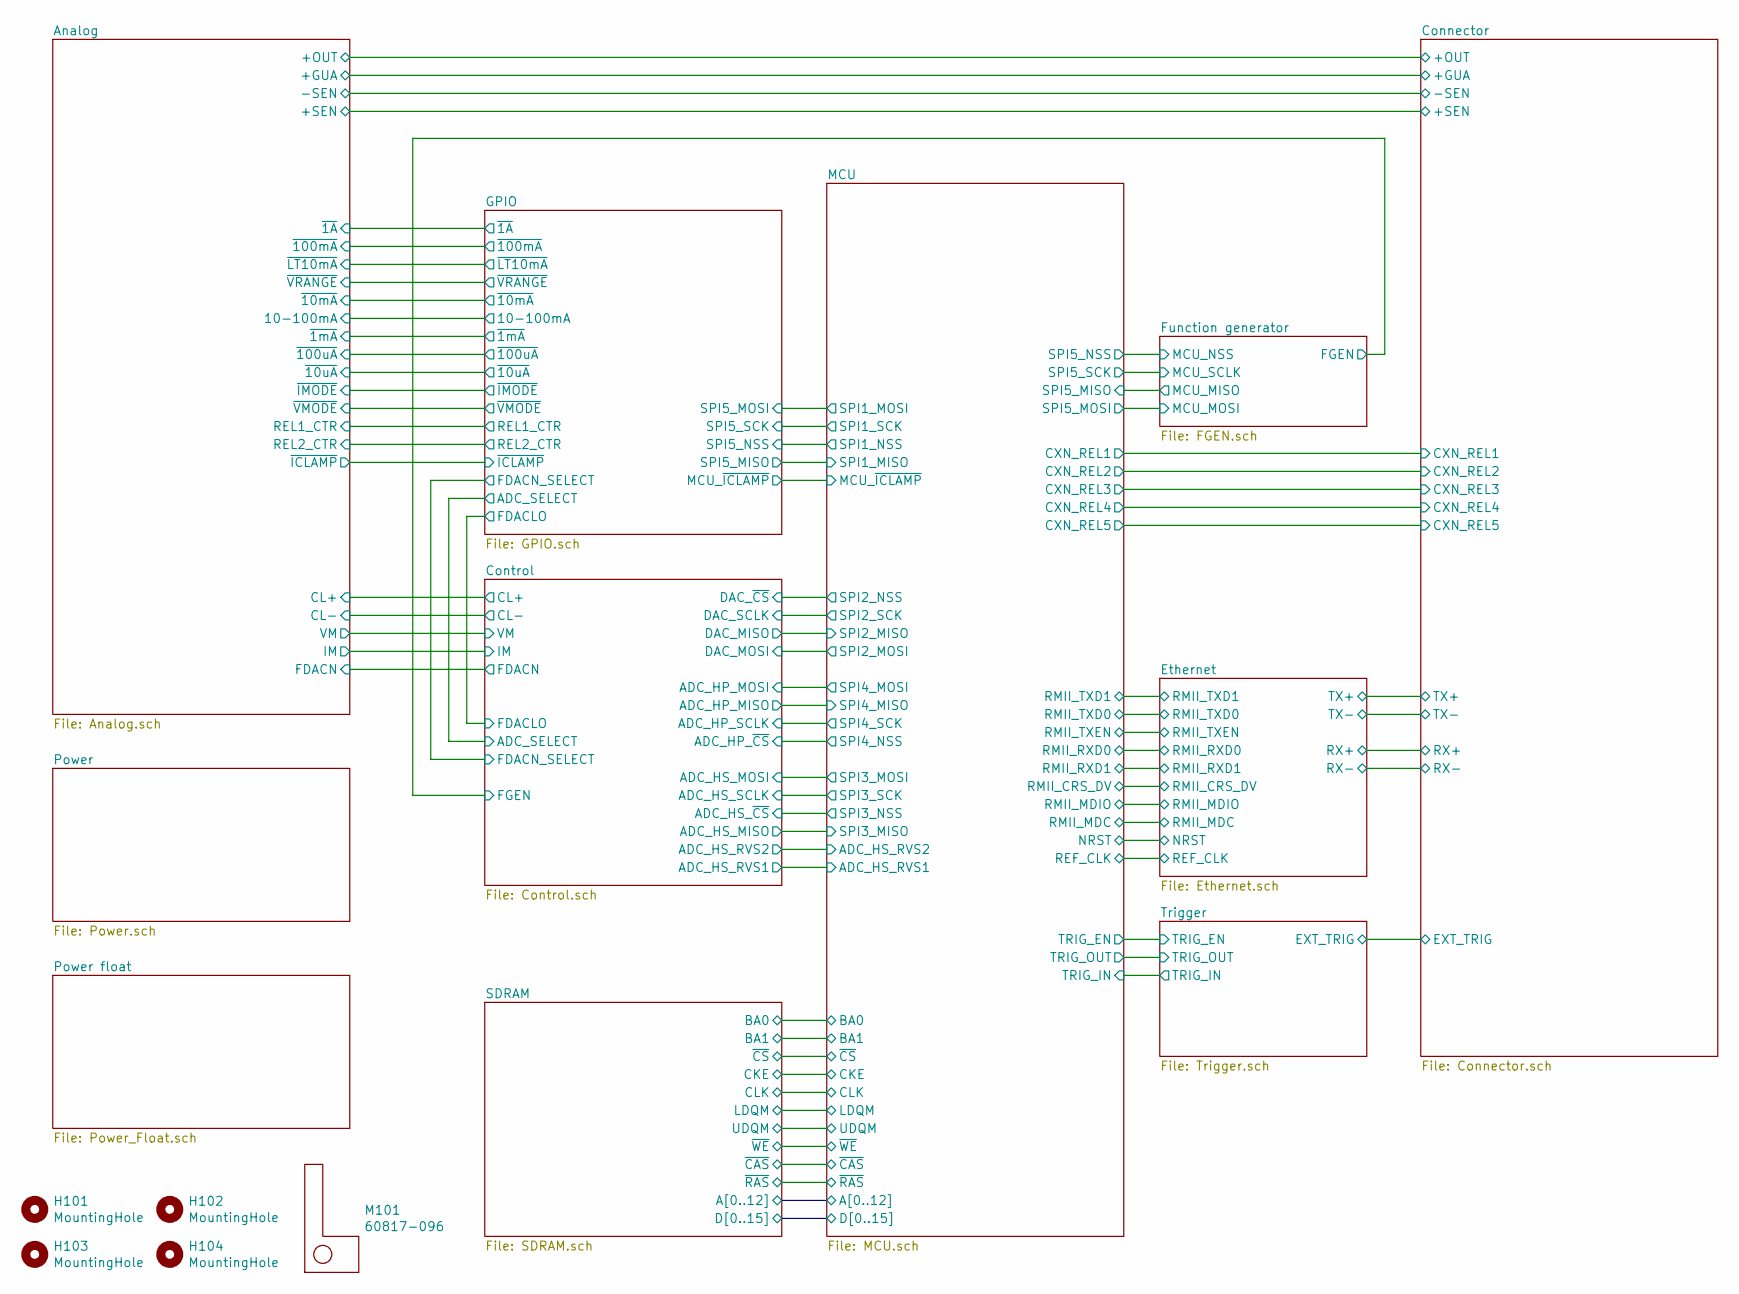
[picture p9: schematic BASE.sch]

Parts:
H101, H102, H103, H104: MountingHole; MountingHole_3.2mm_M3_DIN965_Pad
M101: 60817-096

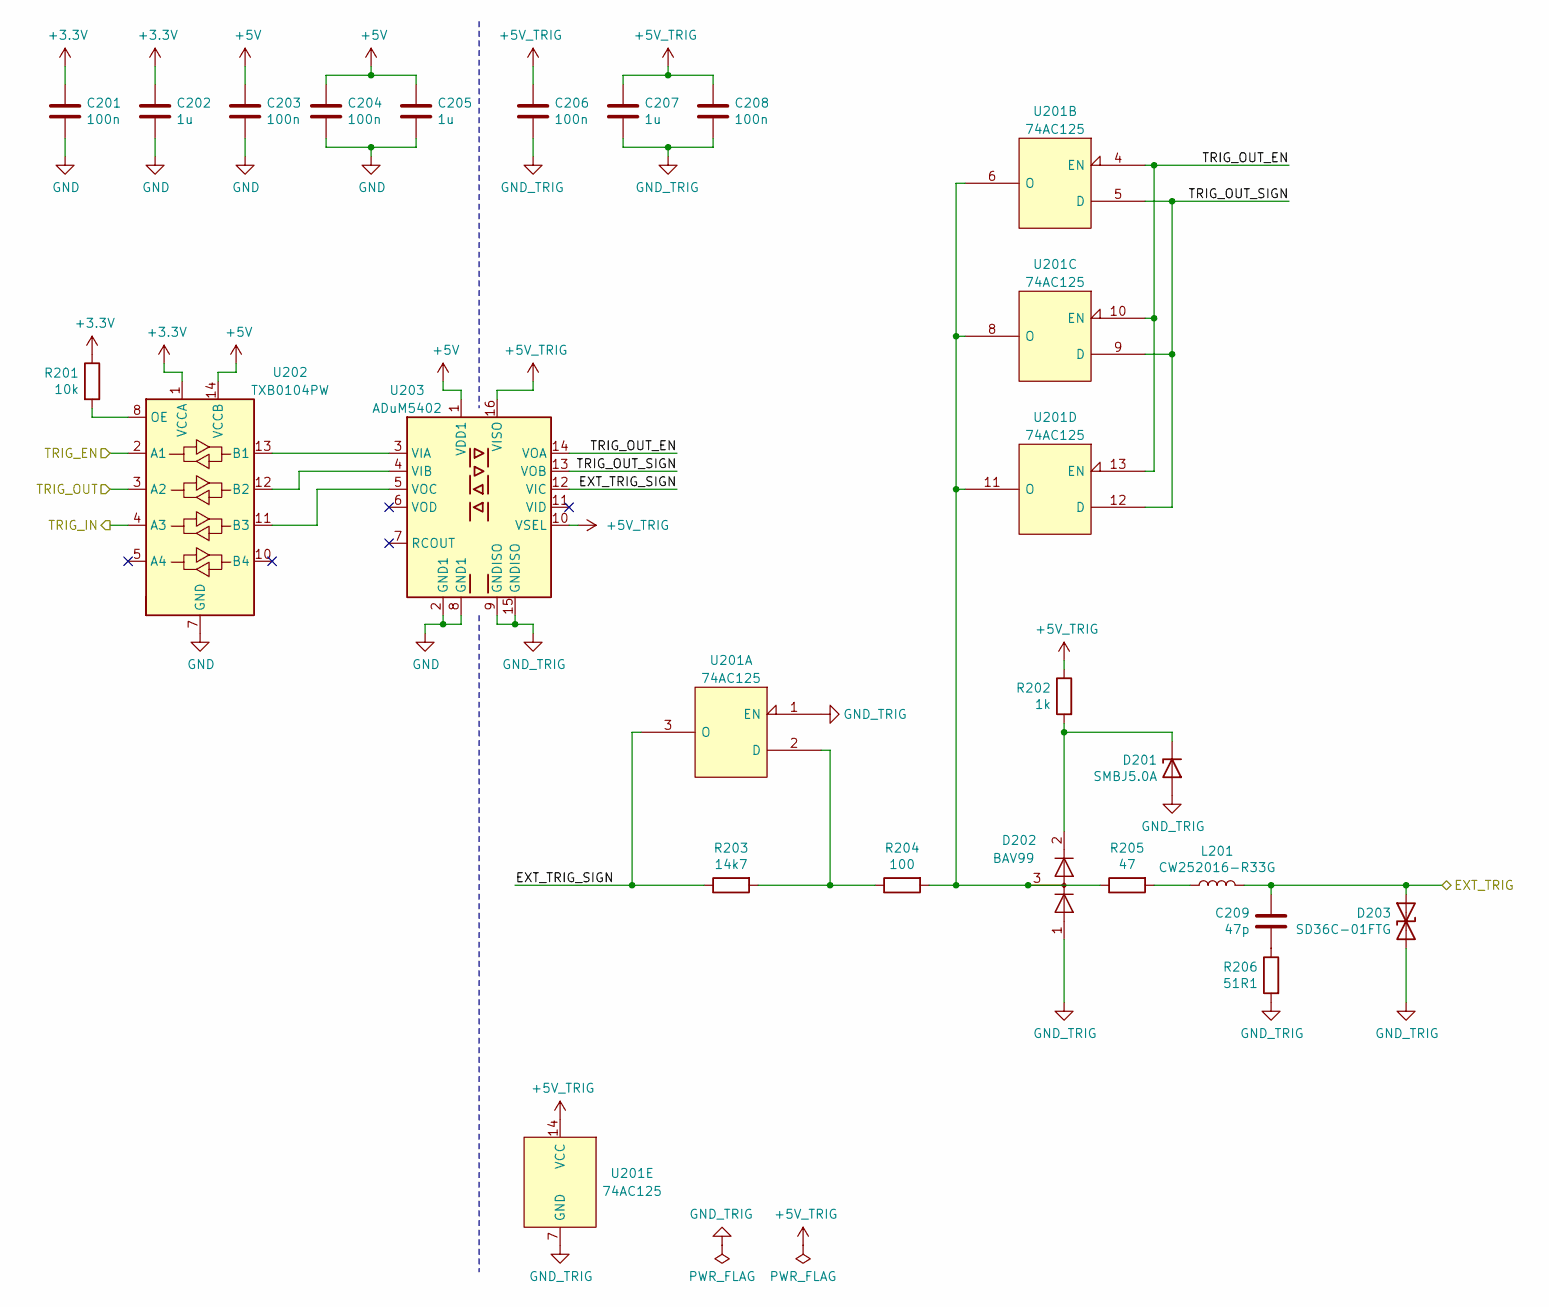
[picture p10: schematic Trigger.sch]

Parts:
C201, C203, C204, C206, C208: 100n; C_0603_1608Metric_Pad1.08x0.95mm_HandSolder
C202, C205, C207: 1u; C_0603_1608Metric_Pad1.08x0.95mm_HandSolder
C209: 47p; C_0603_1608Metric_Pad1.08x0.95mm_HandSolder
D201: SMBJ5.0A; D_SMB
D202: BAV99; SOT-23
D203: SD36C-01FTG; D_SOD-323_HandSoldering
L201: CW252016-R33G; CW252016
R201: 10k; R_0603_1608Metric_Pad0.98x0.95mm_HandSolder
R202: 1k; R_0603_1608Metric_Pad0.98x0.95mm_HandSolder
R203: 14k7; R_0603_1608Metric_Pad0.98x0.95mm_HandSolder
R204: 100; R_0603_1608Metric_Pad0.98x0.95mm_HandSolder
R205: 47; R_0603_1608Metric_Pad0.98x0.95mm_HandSolder
R206: 51R1; R_0603_1608Metric_Pad0.98x0.95mm_HandSolder
U201: 74AC125; TSSOP-14_4.4x5mm_P0.65mm
U202: TXB0104PW; TSSOP-14_4.4x5mm_P0.65mm
U203: ADuM5402; SOIC-16W_7.5x10.3mm_P1.27mm

Connections:
+3V3: C201.1, C202.1, R201.1, U202.1 (VCCA); also elsewhere on the board
+5V: C203.1, C204.1, C205.1, U202.14 (VCCB), U203.1 (VDD1); also elsewhere on the board
+5V_TRIG: C206.1, C207.1, C208.1, R202.1, U201.14 (VCC), U203.10 (VSEL), U203.16 (VISO)
/Connector/EXT_TRIG: C209.1, D203.1 (A1), L201.1; also elsewhere on the board
/MCU/TRIG_EN: U202.2 (A1); also elsewhere on the board
/MCU/TRIG_IN: U202.4 (A3); also elsewhere on the board
/MCU/TRIG_OUT: U202.3 (A2); also elsewhere on the board
/Trigger/EXT_TRIG_SIGN: R203.1, U201.3 (O), U203.12 (VIC)
/Trigger/TRIG_OUT_EN: U201.4 (EN), U201.10 (EN), U201.13 (EN), U203.14 (VOA)
/Trigger/TRIG_OUT_SIGN: U201.5 (D), U201.9 (D), U201.12 (D), U203.13 (VOB)
GND: C201.2, C202.2, C203.2, C204.2, C205.2, U202.7 (GND), U203.2 (GND1), U203.8 (GND1); also elsewhere on the board
GND_TRIG: C206.2, C207.2, C208.2, D201.2 (A), D202.1 (K), D203.2 (A2), R206.2, U201.1 (EN), U201.7 (GND), U203.9 (GNDISO), U203.15 (GNDISO); also elsewhere on the board
unnamed: C209.2, R206.1
unnamed: D201.1 (K), D202.2 (A), R202.2
unnamed: D202.3 (K), R204.2, R205.1, U201.6 (O), U201.8 (O), U201.11 (O)
unnamed: L201.2, R205.2
unnamed: R201.2, U202.8 (OE)
unnamed: R203.2, R204.1, U201.2 (D)
unnamed: U202.11 (B3), U203.5 (VOC)
unnamed: U202.12 (B2), U203.4 (VIB)
unnamed: U202.13 (B1), U203.3 (VIA)

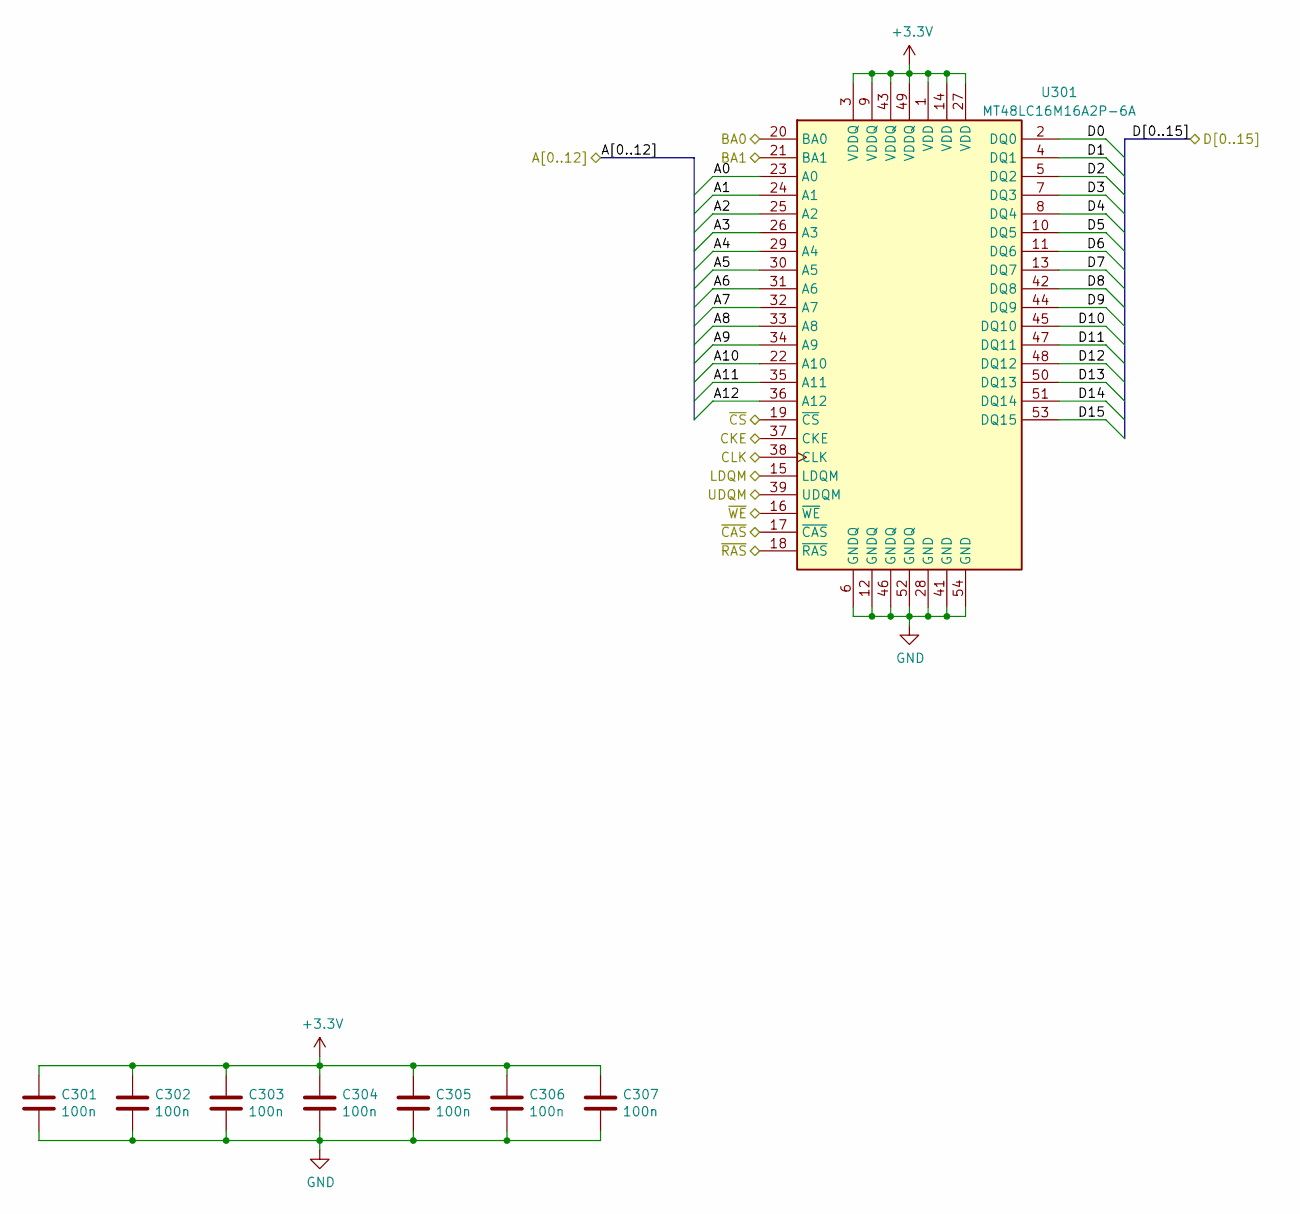
[picture p11: schematic SDRAM.sch]

Parts:
C301, C302, C303, C304, C305, C306, C307: 100n; C_0603_1608Metric_Pad1.08x0.95mm_HandSolder
U301: MT48LC16M16A2P-6A; TSSOP-54

Connections:
+3V3: C301.1, C302.1, C303.1, C304.1, C305.1, C306.1, C307.1, U301.1 (VDD), U301.3 (VDDQ), U301.9 (VDDQ), U301.14 (VDD), U301.27 (VDD), U301.43 (VDDQ), U301.49 (VDDQ); also elsewhere on the board
/MCU/A0: U301.23 (A0); also elsewhere on the board
/MCU/A1: U301.24 (A1); also elsewhere on the board
/MCU/A2: U301.25 (A2); also elsewhere on the board
/MCU/A3: U301.26 (A3); also elsewhere on the board
/MCU/A4: U301.29 (A4); also elsewhere on the board
/MCU/A5: U301.30 (A5); also elsewhere on the board
/MCU/A6: U301.31 (A6); also elsewhere on the board
/MCU/A7: U301.32 (A7); also elsewhere on the board
/MCU/A8: U301.33 (A8); also elsewhere on the board
/MCU/A9: U301.34 (A9); also elsewhere on the board
/MCU/A10: U301.22 (A10); also elsewhere on the board
/MCU/A11: U301.35 (A11); also elsewhere on the board
/MCU/A12: U301.36 (A12); also elsewhere on the board
/MCU/BA0: U301.20 (BA0); also elsewhere on the board
/MCU/BA1: U301.21 (BA1); also elsewhere on the board
/MCU/CKE: U301.37 (CKE); also elsewhere on the board
/MCU/CLK: U301.38 (CLK); also elsewhere on the board
/MCU/D0: U301.2 (DQ0); also elsewhere on the board
/MCU/D1: U301.4 (DQ1); also elsewhere on the board
/MCU/D2: U301.5 (DQ2); also elsewhere on the board
/MCU/D3: U301.7 (DQ3); also elsewhere on the board
/MCU/D4: U301.8 (DQ4); also elsewhere on the board
/MCU/D5: U301.10 (DQ5); also elsewhere on the board
/MCU/D6: U301.11 (DQ6); also elsewhere on the board
/MCU/D7: U301.13 (DQ7); also elsewhere on the board
/MCU/D8: U301.42 (DQ8); also elsewhere on the board
/MCU/D9: U301.44 (DQ9); also elsewhere on the board
/MCU/D10: U301.45 (DQ10); also elsewhere on the board
/MCU/D11: U301.47 (DQ11); also elsewhere on the board
/MCU/D12: U301.48 (DQ12); also elsewhere on the board
/MCU/D13: U301.50 (DQ13); also elsewhere on the board
/MCU/D14: U301.51 (DQ14); also elsewhere on the board
/MCU/D15: U301.53 (DQ15); also elsewhere on the board
/MCU/LDQM: U301.15 (LDQM); also elsewhere on the board
/MCU/UDQM: U301.39 (UDQM); also elsewhere on the board
/MCU/~CAS: U301.17 (~CAS); also elsewhere on the board
/MCU/~CS: U301.19 (~CS); also elsewhere on the board
/MCU/~RAS: U301.18 (~RAS); also elsewhere on the board
/MCU/~WE: U301.16 (~WE); also elsewhere on the board
GND: C301.2, C302.2, C303.2, C304.2, C305.2, C306.2, C307.2, U301.6 (GNDQ), U301.12 (GNDQ), U301.28 (GND), U301.41 (GND), U301.46 (GNDQ), U301.52 (GNDQ), U301.54 (GND); also elsewhere on the board
