BehrensG/ETH1CSMU1/HARDWARE/BASE/BASE.kicad_pcb

## KiCad design HARDWARE/BASE/BASE.kicad_pcb (continued)

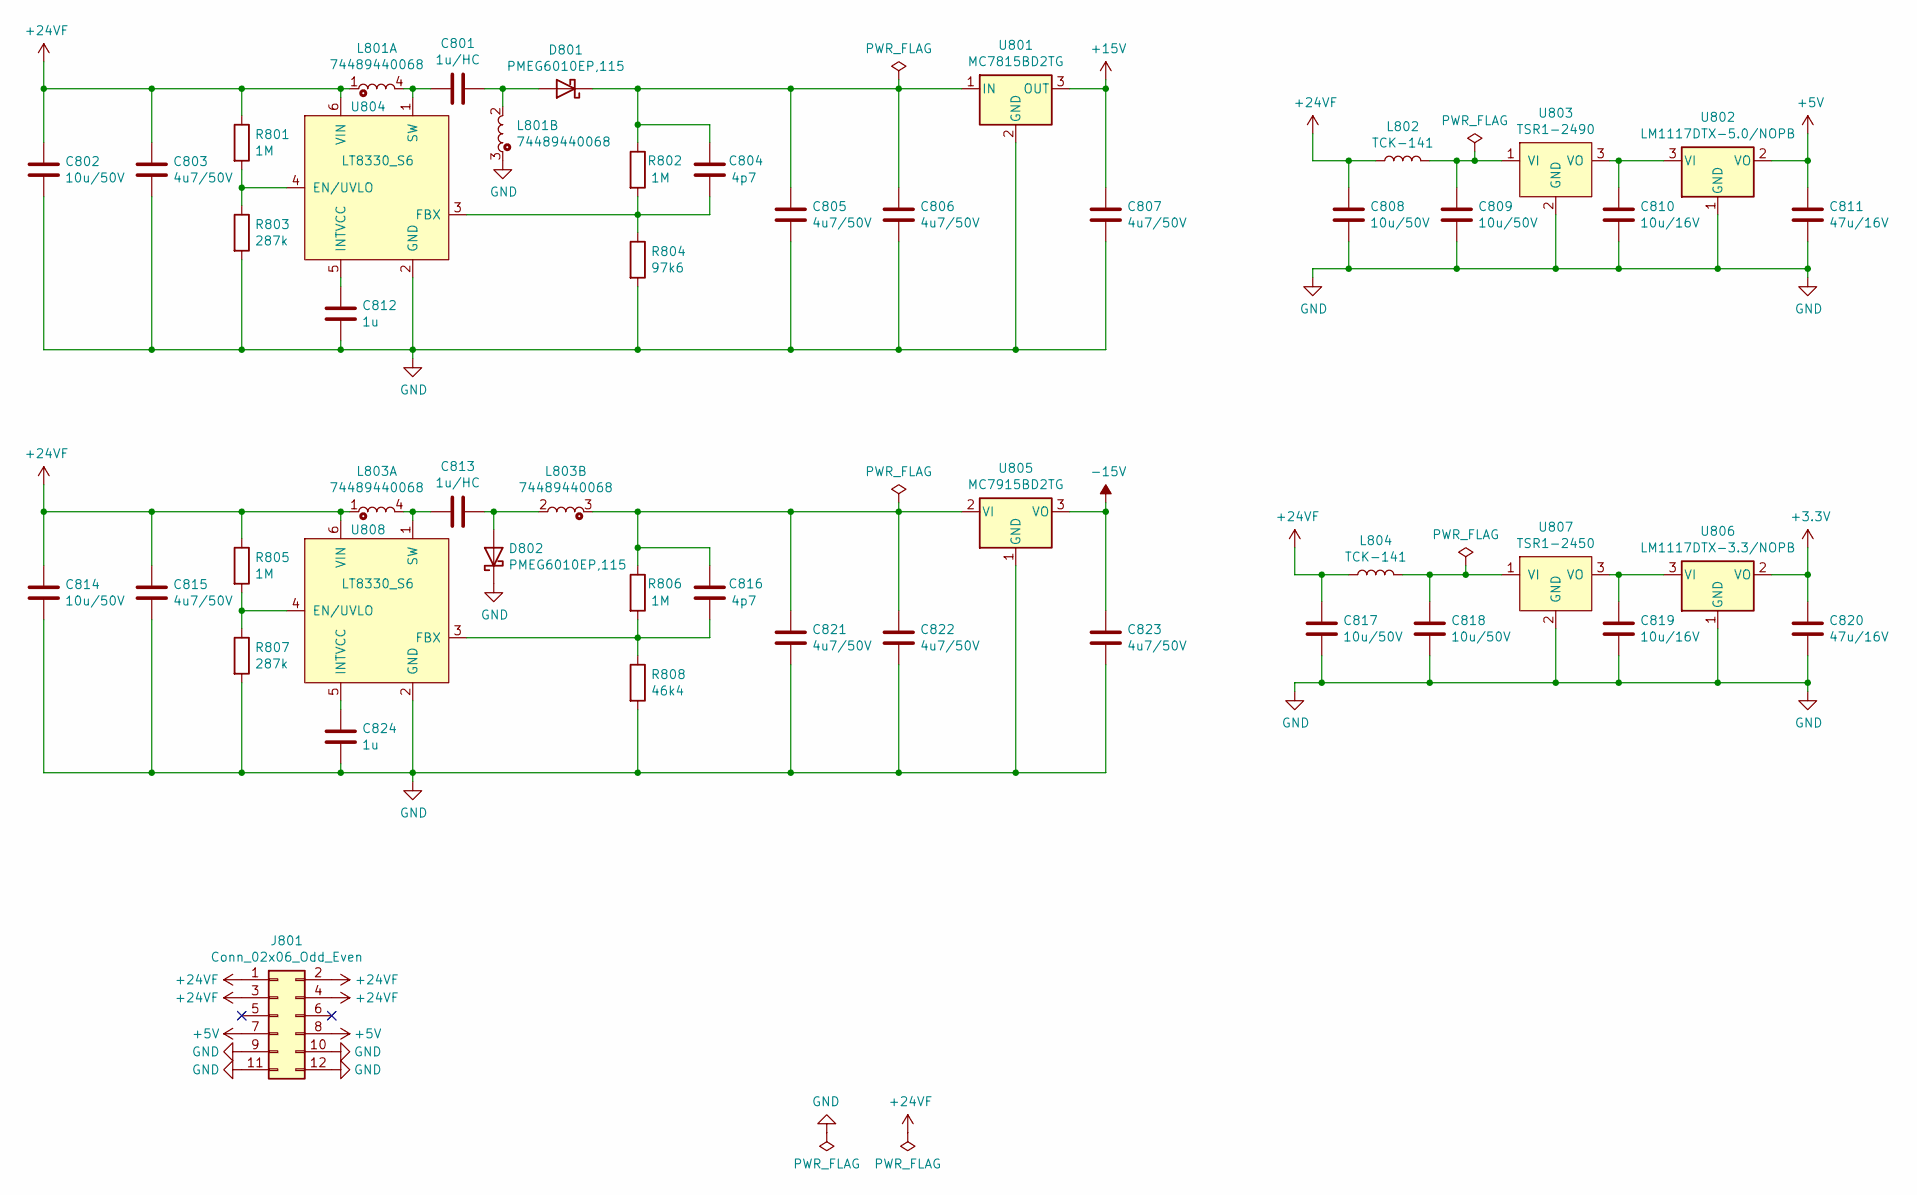
[picture p16: schematic Power_Float.sch, Power float]

Parts:
C801, C813: 1u/HC; C_1206_3216Metric_Pad1.33x1.80mm_HandSolder
C802, C808, C809, C814, C817, C818: 10u/50V; C_1206_3216Metric_Pad1.33x1.80mm_HandSolder
C803, C805, C806, C807, C815, C821, C822, C823: 4u7/50V; C_1206_3216Metric_Pad1.33x1.80mm_HandSolder
C804, C816: 4p7; C_0603_1608Metric_Pad1.08x0.95mm_HandSolder
C810, C819: 10u/16V; C_1206_3216Metric_Pad1.33x1.80mm_HandSolder
C811, C820: 47u/16V; C_1206_3216Metric_Pad1.33x1.80mm_HandSolder
C812, C824: 1u; C_0603_1608Metric_Pad1.08x0.95mm_HandSolder
D801, D802: PMEG6010EP,115; D_SOD-128
J801: Conn_02x06_Odd_Even; PinHeader_2x06_P2.54mm_Vertical
L801, L803: 74489440068
L802, L804: TCK-141
R801, R802, R805, R806: 1M; R_0603_1608Metric_Pad0.98x0.95mm_HandSolder
R803, R807: 287k; R_0603_1608Metric_Pad0.98x0.95mm_HandSolder
R804: 97k6; R_0603_1608Metric_Pad0.98x0.95mm_HandSolder
R808: 46k4; R_0603_1608Metric_Pad0.98x0.95mm_HandSolder
U801: MC7815BD2TG; TO-263-2
U802: LM1117DTX-5.0/NOPB; TO-252-2
U803: TSR1-2490; TSR1
U804, U808: LT8330_S6; TSOT-23-6_HandSoldering
U805: MC7915BD2TG; TO-263-2
U806: LM1117DTX-3.3/NOPB; TO-252-2
U807: TSR1-2450; TSR1

Connections:
+3V3: C820.1, U806.2 (VO); also elsewhere on the board
+5V: C811.1, J801.7, J801.8, U802.2 (VO); also elsewhere on the board
+15V: C807.1, U801.3 (OUT); also elsewhere on the board
+24VF: C802.1, C803.1, C808.1, C814.1, C815.1, C817.1, J801.1, J801.2, J801.3, J801.4, L801.1, L802.1, L803.1, L804.1, R801.1, R805.1, U804.6 (VIN), U808.6 (VIN); also elsewhere on the board
-15V: C823.1, U805.3 (VO); also elsewhere on the board
GND: C802.2, C803.2, C805.2, C806.2, C807.2, C808.2, C809.2, C810.2, C811.2, C812.2, C814.2, C815.2, C817.2, C818.2, C819.2, C820.2, C821.2, C822.2, C823.2, C824.2, D802.1 (K), J801.9, J801.10, J801.11, J801.12, L801.3, R803.2, R804.2, R807.2, R808.2, U801.2 (GND), U802.1 (GND), U803.2 (GND), U804.2 (GND), U805.1 (GND), U806.1 (GND), U807.2 (GND), U808.2 (GND); also elsewhere on the board
unnamed: C801.1, D801.2 (A), L801.2
unnamed: C801.2, L801.4, U804.1 (SW)
unnamed: C804.1, C805.1, C806.1, D801.1 (K), R802.1, U801.1 (IN)
unnamed: C804.2, R802.2, R804.1, U804.3 (FBX)
unnamed: C809.1, L802.2, U803.1 (VI)
unnamed: C810.1, U802.3 (VI), U803.3 (VO)
unnamed: C812.1, U804.5 (INTVCC)
unnamed: C813.1, D802.2 (A), L803.2
unnamed: C813.2, L803.4, U808.1 (SW)
unnamed: C816.1, C821.1, C822.1, L803.3, R806.1, U805.2 (VI)
unnamed: C816.2, R806.2, R808.1, U808.3 (FBX)
unnamed: C818.1, L804.2, U807.1 (VI)
unnamed: C819.1, U806.3 (VI), U807.3 (VO)
unnamed: C824.1, U808.5 (INTVCC)
unnamed: R801.2, R803.1, U804.4 (EN/UVLO)
unnamed: R805.2, R807.1, U808.4 (EN/UVLO)

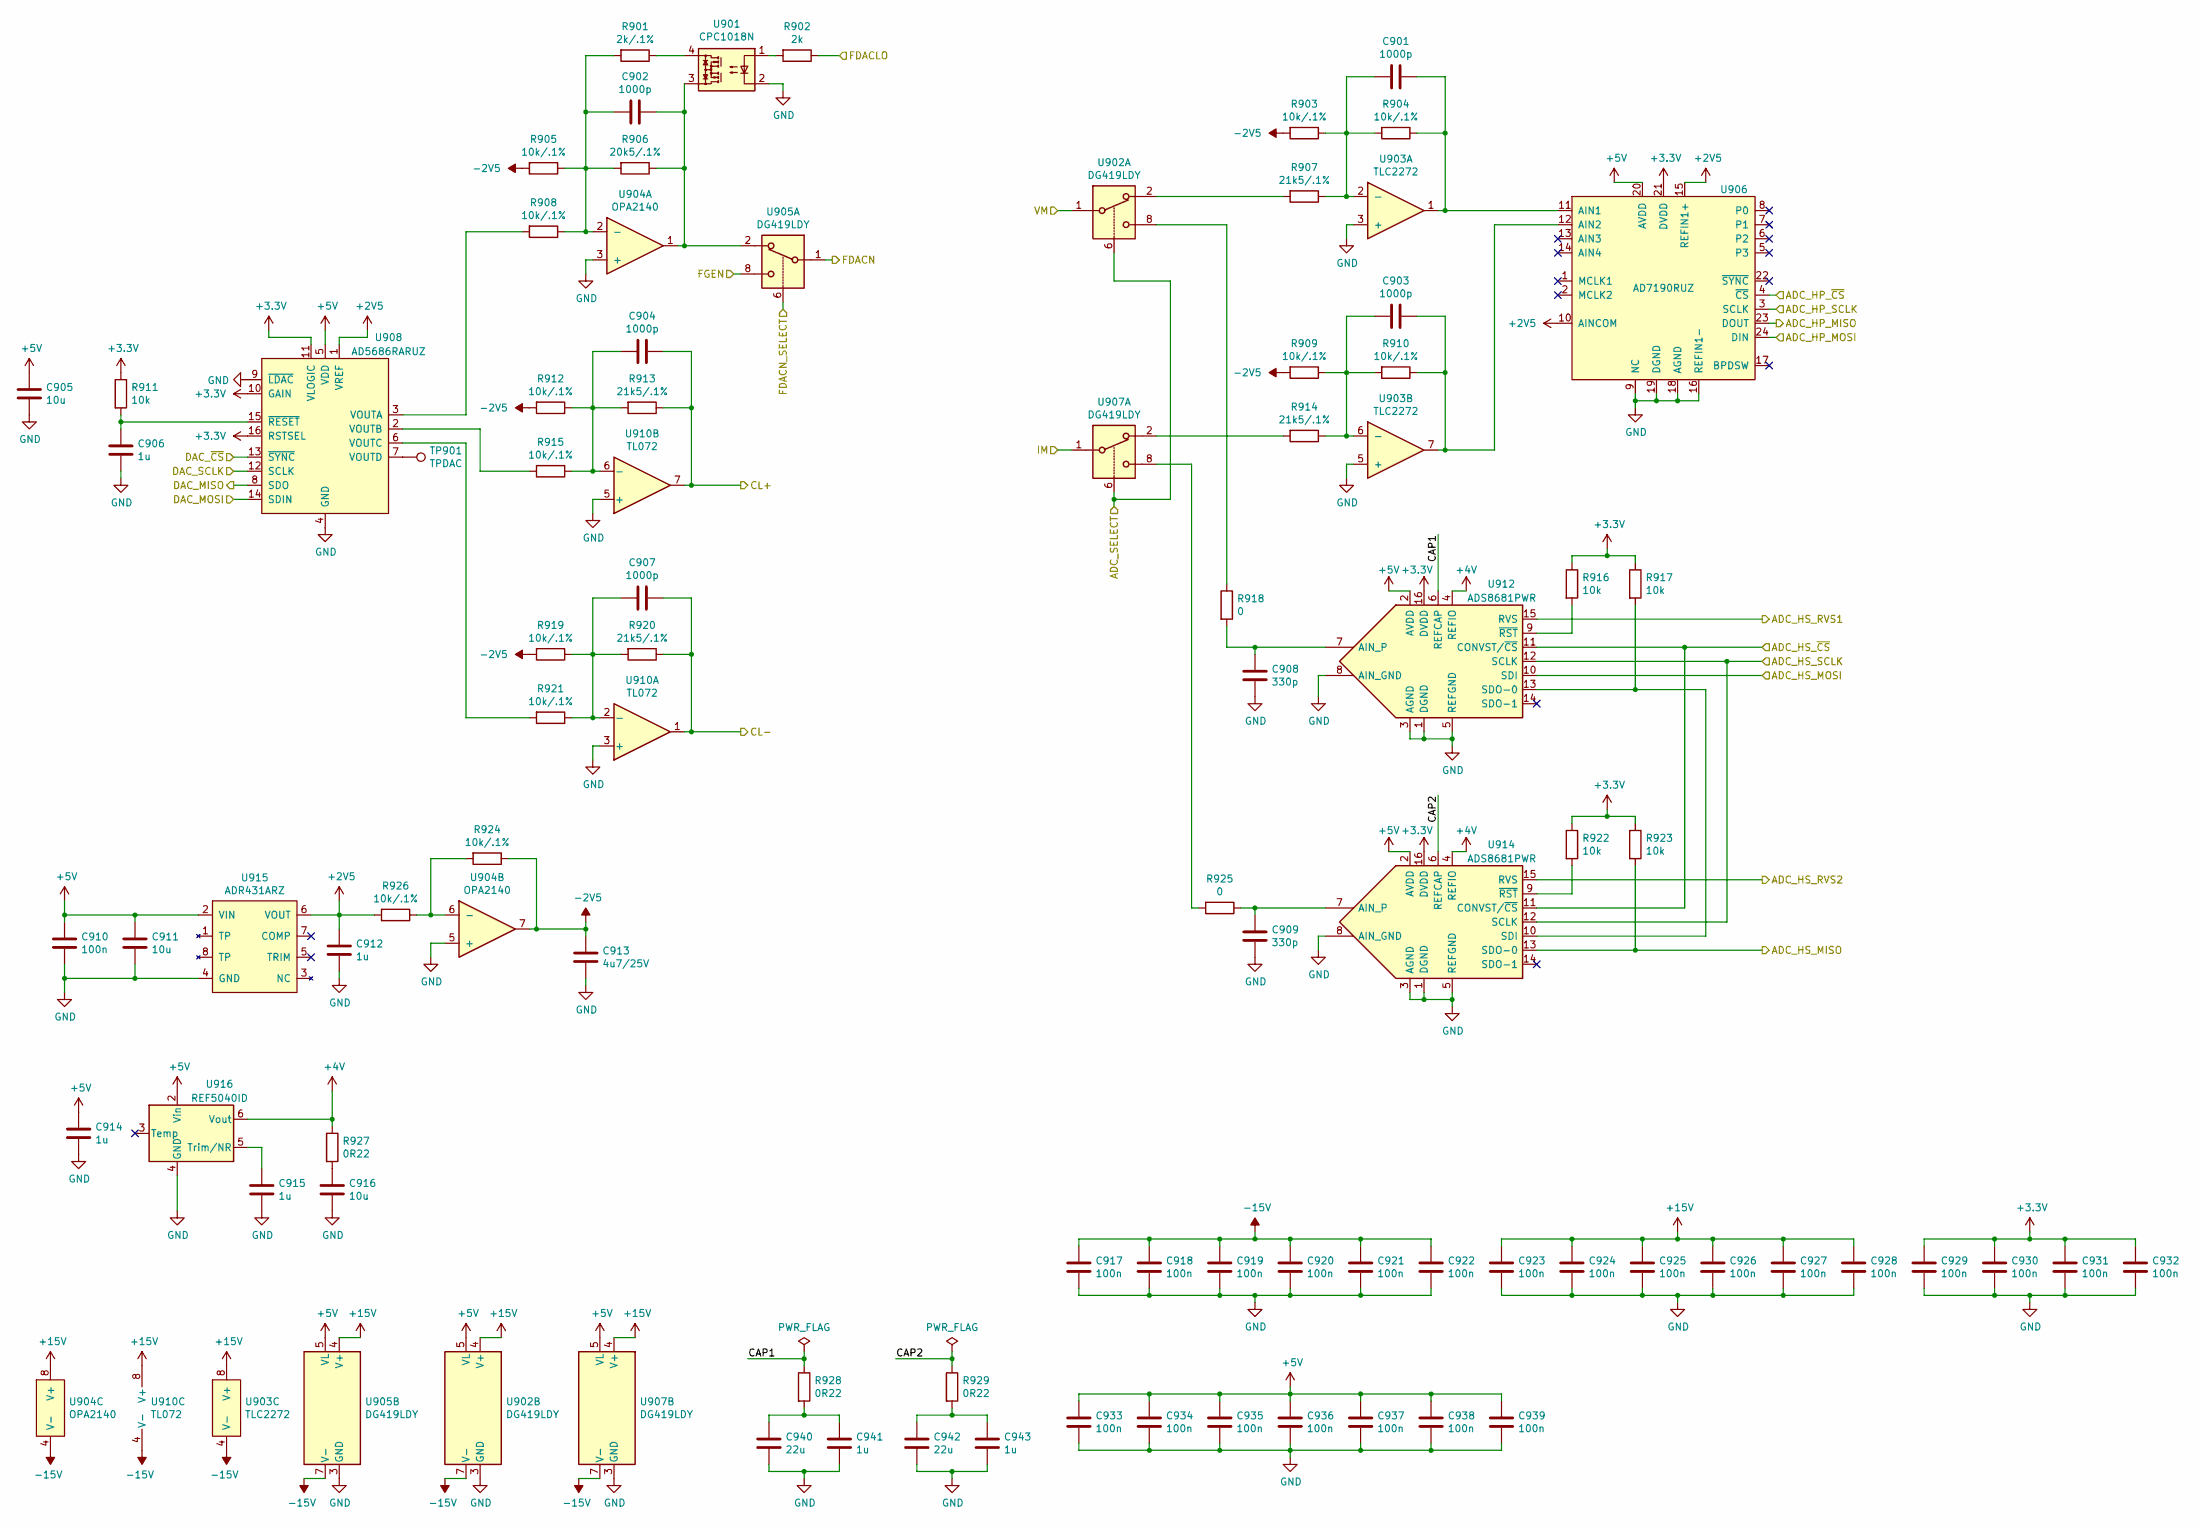
[picture p17: schematic Control.sch]

Parts:
C901, C902, C903, C904, C907: 1000p; C_0603_1608Metric_Pad1.08x0.95mm_HandSolder
C905, C911, C916: 10u; R_0805_2012Metric_Pad1.20x1.40mm_HandSolder
C906, C912, C914, C915, C941, C943: 1u; C_0603_1608Metric_Pad1.08x0.95mm_HandSolder
C908, C909: 330p; C_0603_1608Metric_Pad1.08x0.95mm_HandSolder
C910, C917, C918, C919, C920, C921, C922, C923, C924, C925, C926, C927, C928, C929, C930, C931, C932, C933, C934, C935, C936, C937, C938, C939: 100n; C_0603_1608Metric_Pad1.08x0.95mm_HandSolder
C913: 4u7/25V; C_1206_3216Metric_Pad1.33x1.80mm_HandSolder
C940, C942: 22u; R_0805_2012Metric_Pad1.20x1.40mm_HandSolder
R901: 2k/.1%; R_0805_2012Metric_Pad1.20x1.40mm_HandSolder
R902: 2k; R_0603_1608Metric_Pad0.98x0.95mm_HandSolder
R903, R904, R905, R908, R909, R910, R912, R915, R919, R921, R924, R926: 10k/.1%; R_0805_2012Metric_Pad1.20x1.40mm_HandSolder
R906: 20k5/.1%; R_0805_2012Metric_Pad1.20x1.40mm_HandSolder
R907, R913, R914, R920: 21k5/.1%; R_0805_2012Metric_Pad1.20x1.40mm_HandSolder
R911, R916, R917, R922, R923: 10k; R_0603_1608Metric_Pad0.98x0.95mm_HandSolder
R918, R925: 0; R_0603_1608Metric_Pad0.98x0.95mm_HandSolder
R927, R928, R929: 0R22; R_0603_1608Metric_Pad0.98x0.95mm_HandSolder
TP901: TPDAC; TestPoint_Pad_2.0x2.0mm
U901: CPC1018N; SOP-4_3.8x4.1mm_P2.54mm
U902, U905, U907: DG419LDY; SOIC-8_3.9x4.9mm_P1.27mm
U903: TLC2272; SOIC-8_3.9x4.9mm_P1.27mm
U904: OPA2140; SOIC-8_3.9x4.9mm_P1.27mm
U906: AD7190RUZ; TSSOP-24_4.4x7.8mm_P0.65mm
U908: AD5686RARUZ; TSSOP-16_4.4x5mm_P0.65mm
U910: TL072; SOIC-8_3.9x4.9mm_P1.27mm
U912, U914: ADS8681PWR; TSSOP-16_4.4x5mm_P0.65mm
U915: ADR431ARZ; SOIC-8_3.9x4.9mm_P1.27mm
U916: REF5040ID; SOIC-8_3.9x4.9mm_P1.27mm

Connections:
+2V5: C912.1, R926.2, U906.10 (AINCOM), U906.15 (REFIN1+), U908.1 (VREF), U915.6 (VOUT)
+3V3: C929.1, C930.1, C931.1, C932.1, R911.1, R916.1, R917.1, R922.1, R923.1, U906.21 (DVDD), U908.10 (GAIN), U908.11 (VLOGIC), U908.16 (RSTSEL), U912.16 (DVDD), U914.16 (DVDD); also elsewhere on the board
+4V: R927.1, U912.4 (REFIO), U914.4 (REFIO), U916.6 (Vout)
+5V: C905.1, C910.1, C911.1, C914.1, C933.1, C934.1, C935.1, C936.1, C937.1, C938.1, C939.1, U902.5 (VL), U905.5 (VL), U906.20 (AVDD), U907.5 (VL), U908.5 (VDD), U912.2 (AVDD), U914.2 (AVDD), U915.2 (VIN), U916.2 (Vin); also elsewhere on the board
+15V: C923.1, C924.1, C925.1, C926.1, C927.1, C928.1, U902.4 (V+), U903.8 (V+), U904.8 (V+), U905.4 (V+), U907.4 (V+), U910.8 (V+); also elsewhere on the board
-2V5: C913.1, R903.2, R905.2, R909.2, R912.2, R919.2, R924.1, U904.7
-15V: C917.1, C918.1, C919.1, C920.1, C921.1, C922.1, U902.7 (V-), U903.4 (V-), U904.4 (V-), U905.7 (V-), U907.7 (V-), U910.4 (V-); also elsewhere on the board
/Analog/CL+: C904.1, R913.1, U910.7; also elsewhere on the board
/Analog/CL-: C907.1, R920.1, U910.1; also elsewhere on the board
/Analog/FDACN: U905.1; also elsewhere on the board
/Analog/IM: U907.1; also elsewhere on the board
/Analog/VM: U902.1; also elsewhere on the board
/Control/ADC_HP_MISO: U906.23 (DOUT); also elsewhere on the board
/Control/ADC_HP_MOSI: U906.24 (DIN); also elsewhere on the board
/Control/ADC_HP_SCLK: U906.3 (SCLK); also elsewhere on the board
/Control/ADC_HP_~CS: U906.4 (~CS); also elsewhere on the board
/Control/ADC_HS_MISO: R923.2, U914.13 (SDO-0); also elsewhere on the board
/Control/ADC_HS_MOSI: U912.10 (SDI); also elsewhere on the board
/Control/ADC_HS_RVS1: U912.15 (RVS); also elsewhere on the board
/Control/ADC_HS_RVS2: U914.15 (RVS); also elsewhere on the board
/Control/ADC_HS_SCLK: U912.12 (SCLK), U914.12 (SCLK); also elsewhere on the board
/Control/ADC_HS_~CS: U912.11 (CONVST/~CS), U914.11 (CONVST/~CS); also elsewhere on the board
/Control/ADC_SELECT: U902.6, U907.6; also elsewhere on the board
/Control/CAP1: R928.1, U912.6 (REFCAP)
/Control/CAP2: R929.1, U914.6 (REFCAP)
/Control/DAC_MISO: U908.8 (SDO); also elsewhere on the board
/Control/DAC_MOSI: U908.14 (SDIN); also elsewhere on the board
/Control/DAC_SCLK: U908.12 (SCLK); also elsewhere on the board
/Control/DAC_~CS: U908.13 (~SYNC); also elsewhere on the board
/Control/FDACLO: R902.1; also elsewhere on the board
/Control/FDACN_SELECT: U905.6; also elsewhere on the board
/Control/FGEN: U905.8; also elsewhere on the board
GND: C905.2, C906.2, C908.2, C909.2, C910.2, C911.2, C912.2, C913.2, C914.2, C915.2, C916.2, C917.2, C918.2, C919.2, C920.2, C921.2, C922.2, C923.2, C924.2, C925.2, C926.2, C927.2, C928.2, C929.2, C930.2, C931.2, C932.2, C933.2, C934.2, C935.2, C936.2, C937.2, C938.2, C939.2, C940.2, C941.2, C942.2, C943.2, U901.2, U902.3 (GND), U903.3 (+), U903.5 (+), U904.3 (+), U904.5 (+), U905.3 (GND), U906.9 (NC), U906.16 (REFIN1-), U906.18 (AGND), U906.19 (DGND), U907.3 (GND), U908.4 (GND), U908.9 (~LDAC), U910.3 (+), U910.5 (+), U912.1 (DGND), U912.3 (AGND), U912.5 (REFGND), U912.8 (AIN_GND), U914.1 (DGND), U914.3 (AGND), U914.5 (REFGND), U914.8 (AIN_GND), U915.4 (GND), U916.4 (GND); also elsewhere on the board
unnamed: C901.1, R904.1, U903.1, U906.11 (AIN1)
unnamed: C901.2, R903.1, R904.2, R907.1, U903.2 (-)
unnamed: C902.1, R906.1, U901.3, U904.1, U905.2
unnamed: C902.2, R901.2, R905.1, R906.2, R908.1, U904.2 (-)
unnamed: C903.1, R910.1, U903.7, U906.12 (AIN2)
unnamed: C903.2, R909.1, R910.2, R914.1, U903.6 (-)
unnamed: C904.2, R912.1, R913.2, R915.1, U910.6 (-)
unnamed: C906.1, R911.2, U908.15 (~RESET)
unnamed: C907.2, R919.1, R920.2, R921.1, U910.2 (-)
unnamed: C908.1, R918.2, U912.7 (AIN_P)
unnamed: C909.1, R925.1, U914.7 (AIN_P)
unnamed: C915.1, U916.5 (Trim/NR)
unnamed: C916.1, R927.2
unnamed: C940.1, C941.1, R928.2
unnamed: C942.1, C943.1, R929.2
unnamed: R901.1, U901.4
unnamed: R902.2, U901.1
unnamed: R907.2, U902.2
unnamed: R908.2, U908.3 (VOUTA)
unnamed: R914.2, U907.2
unnamed: R915.2, U908.2 (VOUTB)
unnamed: R916.2, U912.9 (~RST)
unnamed: R917.2, U912.13 (SDO-0), U914.10 (SDI)
unnamed: R918.1, U902.8
unnamed: R921.2, U908.6 (VOUTC)
unnamed: R922.2, U914.9 (~RST)
unnamed: R924.2, R926.1, U904.6 (-)
unnamed: R925.2, U907.8
unnamed: TP901.1, U908.7 (VOUTD)

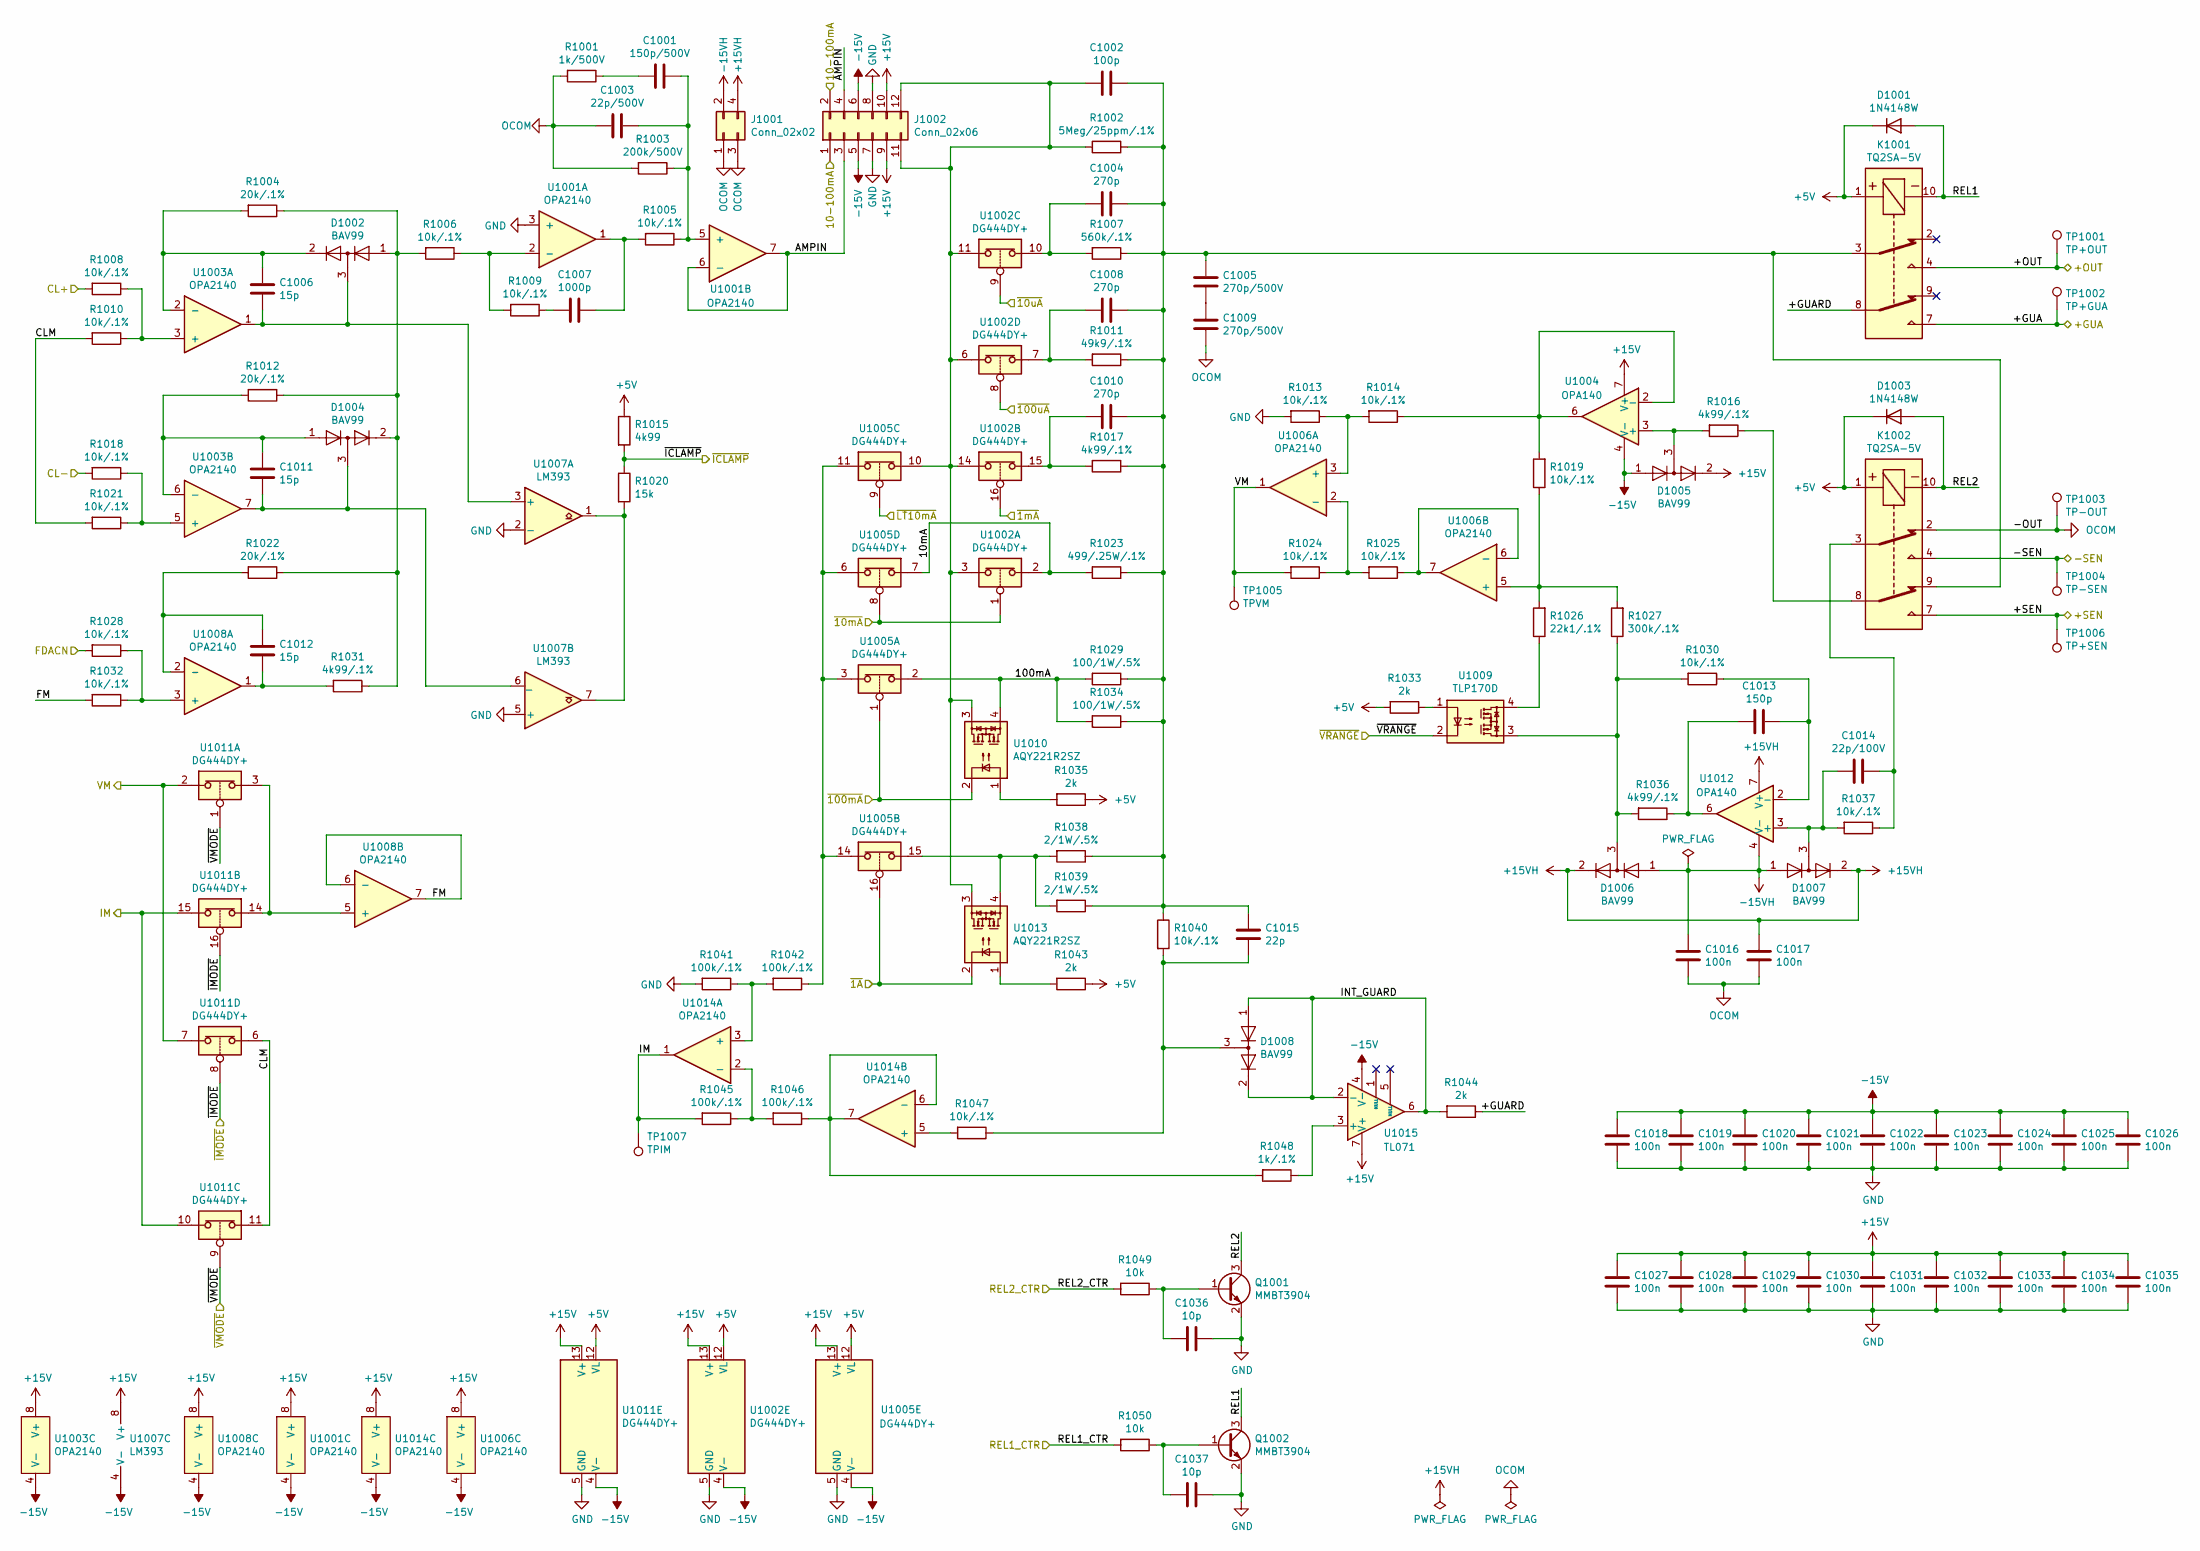
[picture p18: schematic Analog.sch]

Parts:
C1001: 150p/500V; C_0805_2012Metric_Pad1.18x1.45mm_HandSolder
C1002: 100p; C_0603_1608Metric_Pad1.08x0.95mm_HandSolder
C1003: 22p/500V; C_0805_2012Metric_Pad1.18x1.45mm_HandSolder
C1004, C1008, C1010: 270p; C_0603_1608Metric_Pad1.08x0.95mm_HandSolder
C1005, C1009: 270p/500V; C_0805_2012Metric_Pad1.18x1.45mm_HandSolder
C1006, C1011, C1012: 15p; C_0603_1608Metric_Pad1.08x0.95mm_HandSolder
C1007: 1000p; C_0603_1608Metric_Pad1.08x0.95mm_HandSolder
C1013: 150p; C_0603_1608Metric_Pad1.08x0.95mm_HandSolder
C1014: 22p/100V; C_0805_2012Metric_Pad1.18x1.45mm_HandSolder
C1015: 22p; C_0603_1608Metric_Pad1.08x0.95mm_HandSolder
C1016, C1017, C1018, C1019, C1020, C1021, C1022, C1023, C1024, C1025, C1026, C1027, C1028, C1029, C1030, C1031, C1032, C1033, C1034, C1035: 100n; C_0603_1608Metric_Pad1.08x0.95mm_HandSolder
C1036, C1037: 10p; C_0603_1608Metric_Pad1.08x0.95mm_HandSolder
D1001, D1003: 1N4148W; D_SOD-123
D1002, D1004, D1005, D1006, D1007, D1008: BAV99; SOT-23
J1001: Conn_02x02; PinHeader_2x02_P2.54mm_Vertical
J1002: Conn_02x06; PinHeader_2x06_P2.54mm_Vertical
K1001, K1002: TQ2SA-5V; SA
Q1001, Q1002: MMBT3904; SOT-23
R1001: 1k/500V; R_1206_3216Metric_Pad1.30x1.75mm_HandSolder
R1002: 5Meg/25ppm/.1%; R_1206_3216Metric_Pad1.30x1.75mm_HandSolder
R1003: 200k/500V; R_1206_3216Metric_Pad1.30x1.75mm_HandSolder
R1004, R1012, R1022: 20k/.1%; R_0805_2012Metric_Pad1.20x1.40mm_HandSolder
R1005, R1006, R1008, R1009, R1010, R1013, R1014, R1018, R1019, R1021, R1024, R1025, R1028, R1030, R1032, R1037, R1040, R1047: 10k/.1%; R_0805_2012Metric_Pad1.20x1.40mm_HandSolder
R1007: 560k/.1%; R_0805_2012Metric_Pad1.20x1.40mm_HandSolder
R1011: 49k9/.1%; R_0805_2012Metric_Pad1.20x1.40mm_HandSolder
R1015: 4k99; R_0603_1608Metric_Pad0.98x0.95mm_HandSolder
R1016, R1017, R1031, R1036: 4k99/.1%; R_0805_2012Metric_Pad1.20x1.40mm_HandSolder
R1020: 15k; R_0603_1608Metric_Pad0.98x0.95mm_HandSolder
R1023: 499/.25W/.1%; R_0805_2012Metric_Pad1.20x1.40mm_HandSolder
R1026: 22k1/.1%; R_0805_2012Metric_Pad1.20x1.40mm_HandSolder
R1027: 300k/.1%; R_0805_2012Metric_Pad1.20x1.40mm_HandSolder
R1029, R1034: 100/1W/.5%; R_2512_6332Metric_Pad1.40x3.35mm_HandSolder
R1033, R1043, R1044: 2k; R_0603_1608Metric_Pad0.98x0.95mm_HandSolder
R1035: 2k; R_0805_2012Metric_Pad1.20x1.40mm_HandSolder
R1038, R1039: 2/1W/.5%; R_2512_6332Metric_Pad1.40x3.35mm_HandSolder
R1041, R1042, R1045, R1046: 100k/.1%; R_0805_2012Metric_Pad1.20x1.40mm_HandSolder
R1048: 1k/.1%; R_0603_1608Metric_Pad0.98x0.95mm_HandSolder
R1049, R1050: 10k; R_0603_1608Metric_Pad0.98x0.95mm_HandSolder
TP1001: TP+OUT; TestPoint_Pad_2.0x2.0mm
TP1002: TP+GUA; TestPoint_Pad_2.0x2.0mm
TP1003: TP-OUT; TestPoint_Pad_2.0x2.0mm
TP1004: TP-SEN; TestPoint_Pad_2.0x2.0mm
TP1005: TPVM; TestPoint_Pad_2.0x2.0mm
TP1006: TP+SEN; TestPoint_Pad_2.0x2.0mm
TP1007: TPIM; TestPoint_Pad_2.0x2.0mm
U1001, U1003, U1006, U1008, U1014: OPA2140; SOIC-8_3.9x4.9mm_P1.27mm
U1002, U1005, U1011: DG444DY+; SOIC-16_3.9x9.9mm_P1.27mm
U1004, U1012: OPA140; SOIC-8_3.9x4.9mm_P1.27mm
U1007: LM393; SOIC-8_3.9x4.9mm_P1.27mm
U1009: TLP170D; SO-4_4.4x3.9mm_P2.54mm
U1010, U1013: AQY221R2SZ; AQY212GS
U1015: TL071; SOIC-8_3.9x4.9mm_P1.27mm

Connections:
+5V: D1001.1 (K), D1003.1 (K), K1001.1, K1002.1, R1015.1, R1033.2, R1035.1, R1043.1, U1002.12 (VL), U1005.12 (VL), U1011.12 (VL); also elsewhere on the board
+15V: C1027.1, C1028.1, C1029.1, C1030.1, C1031.1, C1032.1, C1033.1, C1034.1, C1035.1, D1005.2 (A), J1002.9, J1002.10, U1001.8 (V+), U1002.13 (V+), U1003.8 (V+), U1004.7 (V+), U1005.13 (V+), U1006.8 (V+), U1007.8 (V+), U1008.8 (V+), U1011.13 (V+), U1014.8 (V+), U1015.7 (V+); also elsewhere on the board
+15VH: C1017.1, D1006.2 (A), D1007.2 (A), J1001.4, U1012.7 (V+)
-15V: C1018.1, C1019.1, C1020.1, C1021.1, C1022.1, C1023.1, C1024.1, C1025.1, C1026.1, D1005.1 (K), J1002.5, J1002.6, U1001.4 (V-), U1002.4 (V-), U1003.4 (V-), U1004.4 (V-), U1005.4 (V-), U1006.4 (V-), U1007.4 (V-), U1008.4 (V-), U1011.4 (V-), U1014.4 (V-), U1015.4 (V-); also elsewhere on the board
-15VH: C1016.1, D1006.1 (K), D1007.1 (K), J1001.2, U1012.4 (V-)
/Analog/10-100mA: J1002.1, J1002.2; also elsewhere on the board
/Analog/10mA: R1023.2, U1002.2, U1005.7
/Analog/100mA: R1029.2, R1034.2, U1005.2, U1010.4
/Analog/+GUA: K1001.7, TP1002.1; also elsewhere on the board
/Analog/+GUARD: K1001.8, R1044.1
/Analog/+OUT: K1001.4, TP1001.1; also elsewhere on the board
/Analog/+SEN: K1002.7, TP1006.1; also elsewhere on the board
/Analog/-SEN: K1002.4, TP1004.1; also elsewhere on the board
/Analog/AMPIN: J1002.3, J1002.4, U1001.6 (-), U1001.7
/Analog/CL+: R1008.2; also elsewhere on the board
/Analog/CL-: R1018.2; also elsewhere on the board
/Analog/CLM: R1010.2, R1021.2, U1011.6, U1011.11
/Analog/FDACN: R1028.2; also elsewhere on the board
/Analog/FM: R1032.2, U1008.6 (-), U1008.7
/Analog/IM: R1045.2, TP1007.1, U1011.10, U1011.15, U1014.1; also elsewhere on the board
/Analog/INT_GUARD: D1008.1 (K), D1008.2 (A), R1044.2, U1015.2 (-), U1015.6
/Analog/REL1: D1001.2 (A), K1001.10, Q1002.3 (C)
/Analog/REL1_CTR: R1050.2; also elsewhere on the board
/Analog/REL2: D1003.2 (A), K1002.10, Q1001.3 (C)
/Analog/REL2_CTR: R1049.2; also elsewhere on the board
/Analog/VM: R1024.2, TP1005.1, U1006.1, U1011.2, U1011.7; also elsewhere on the board
/Analog/~1A: U1005.16, U1013.2; also elsewhere on the board
/Analog/~1mA: U1002.16; also elsewhere on the board
/Analog/~10mA: U1002.1, U1005.8; also elsewhere on the board
/Analog/~10uA: U1002.9; also elsewhere on the board
/Analog/~100mA: U1005.1, U1010.2; also elsewhere on the board
/Analog/~100uA: U1002.8; also elsewhere on the board
/Analog/~ICLAMP: R1015.2, R1020.1; also elsewhere on the board
/Analog/~IMODE: U1011.8, U1011.16; also elsewhere on the board
/Analog/~LT10mA: U1005.9; also elsewhere on the board
/Analog/~VMODE: U1011.1, U1011.9; also elsewhere on the board
/Analog/~VRANGE: U1009.2; also elsewhere on the board
GND: C1018.2, C1019.2, C1020.2, C1021.2, C1022.2, C1023.2, C1024.2, C1025.2, C1026.2, C1027.2, C1028.2, C1029.2, C1030.2, C1031.2, C1032.2, C1033.2, C1034.2, C1035.2, C1036.1, C1037.1, J1002.7, J1002.8, Q1001.2 (E), Q1002.2 (E), R1013.2, R1041.2, U1001.3 (+), U1002.5 (GND), U1005.5 (GND), U1007.2 (-), U1007.5 (+), U1011.5 (GND); also elsewhere on the board
unnamed: C1001.1, C1003.1, R1003.1, R1005.1, U1001.5 (+)
unnamed: C1001.2, R1001.1
unnamed: C1002.1, C1004.1, C1005.1, C1008.1, C1010.1, C1015.1, K1001.3, K1002.9, R1002.1, R1007.1, R1011.1, R1017.1, R1023.1, R1029.1, R1034.1, R1038.1, R1039.1, R1040.1
unnamed: C1002.2, J1002.11, J1002.12, R1002.2, U1002.3, U1002.6, U1002.11, U1002.14, U1005.10, U1010.3, U1013.3
unnamed: C1004.2, R1007.2, U1002.10
unnamed: C1005.2, C1009.1
unnamed: C1006.1, D1002.2 (A), R1004.2, U1003.2 (-)
unnamed: C1006.2, D1002.3 (K), U1003.1, U1007.3 (+)
unnamed: C1007.1, R1005.2, U1001.1
unnamed: C1007.2, R1009.1
unnamed: C1008.2, R1011.2, U1002.7
unnamed: C1010.2, R1017.2, U1002.15
unnamed: C1011.1, D1004.1 (K), R1012.2, U1003.6 (-)
unnamed: C1011.2, D1004.3 (K), U1003.7, U1007.6 (_)
unnamed: C1012.1, R1022.2, U1008.2 (-)
unnamed: C1012.2, R1031.2, U1008.1
unnamed: C1013.1, R1030.1, U1012.2 (-)
unnamed: C1013.2, R1036.1, U1012.6
unnamed: C1014.1, K1002.3, R1037.1
unnamed: C1014.2, D1007.3 (K), R1037.2, U1012.3 (+)
unnamed: C1015.2, D1008.3 (K), R1040.2, R1047.1
unnamed: C1036.2, Q1001.1 (B), R1049.1
unnamed: C1037.2, Q1002.1 (B), R1050.1
unnamed: D1002.1 (K), D1004.2 (A), R1004.1, R1006.2, R1012.1, R1022.1, R1031.1
unnamed: D1005.3 (K), R1016.2, U1004.3 (+)
unnamed: D1006.3 (K), R1027.1, R1030.2, R1036.2, U1009.3
unnamed: K1002.8, R1016.1
unnamed: R1006.1, R1009.2, U1001.2 (-)
unnamed: R1008.1, R1010.1, U1003.3 (+)
unnamed: R1013.1, R1014.2, U1006.3 (+)
unnamed: R1014.1, R1019.2, U1004.2 (-), U1004.6
unnamed: R1018.1, R1021.1, U1003.5 (+)
unnamed: R1019.1, R1026.2, R1027.2, U1006.5 (+)
unnamed: R1020.2, U1007.1, U1007.7
unnamed: R1024.1, R1025.2, U1006.2 (-)
unnamed: R1025.1, U1006.6 (-), U1006.7
unnamed: R1026.1, U1009.4
unnamed: R1028.1, R1032.1, U1008.3 (+)
unnamed: R1033.1, U1009.1
unnamed: R1035.2, U1010.1
unnamed: R1038.2, R1039.2, U1005.15, U1013.4
unnamed: R1041.1, R1042.2, U1014.3 (+)
unnamed: R1042.1, U1005.3, U1005.6, U1005.11, U1005.14
unnamed: R1043.2, U1013.1
unnamed: R1045.1, R1046.2, U1014.2 (-)
unnamed: R1046.1, R1048.2, U1014.6 (-), U1014.7
unnamed: R1047.2, U1014.5 (+)
unnamed: R1048.1, U1015.3 (+)
unnamed: U1008.5 (+), U1011.3, U1011.14
OCOM: C1003.2, C1009.2, C1016.2, C1017.2, J1001.1, J1001.3, K1002.2, R1001.2, R1003.2, TP1003.1; also elsewhere on the board
