BehrensG/ETH1CSMU1/HARDWARE/BASE/BASE.kicad_pcb

## KiCad design HARDWARE/BASE/BASE.kicad_pcb (continued)

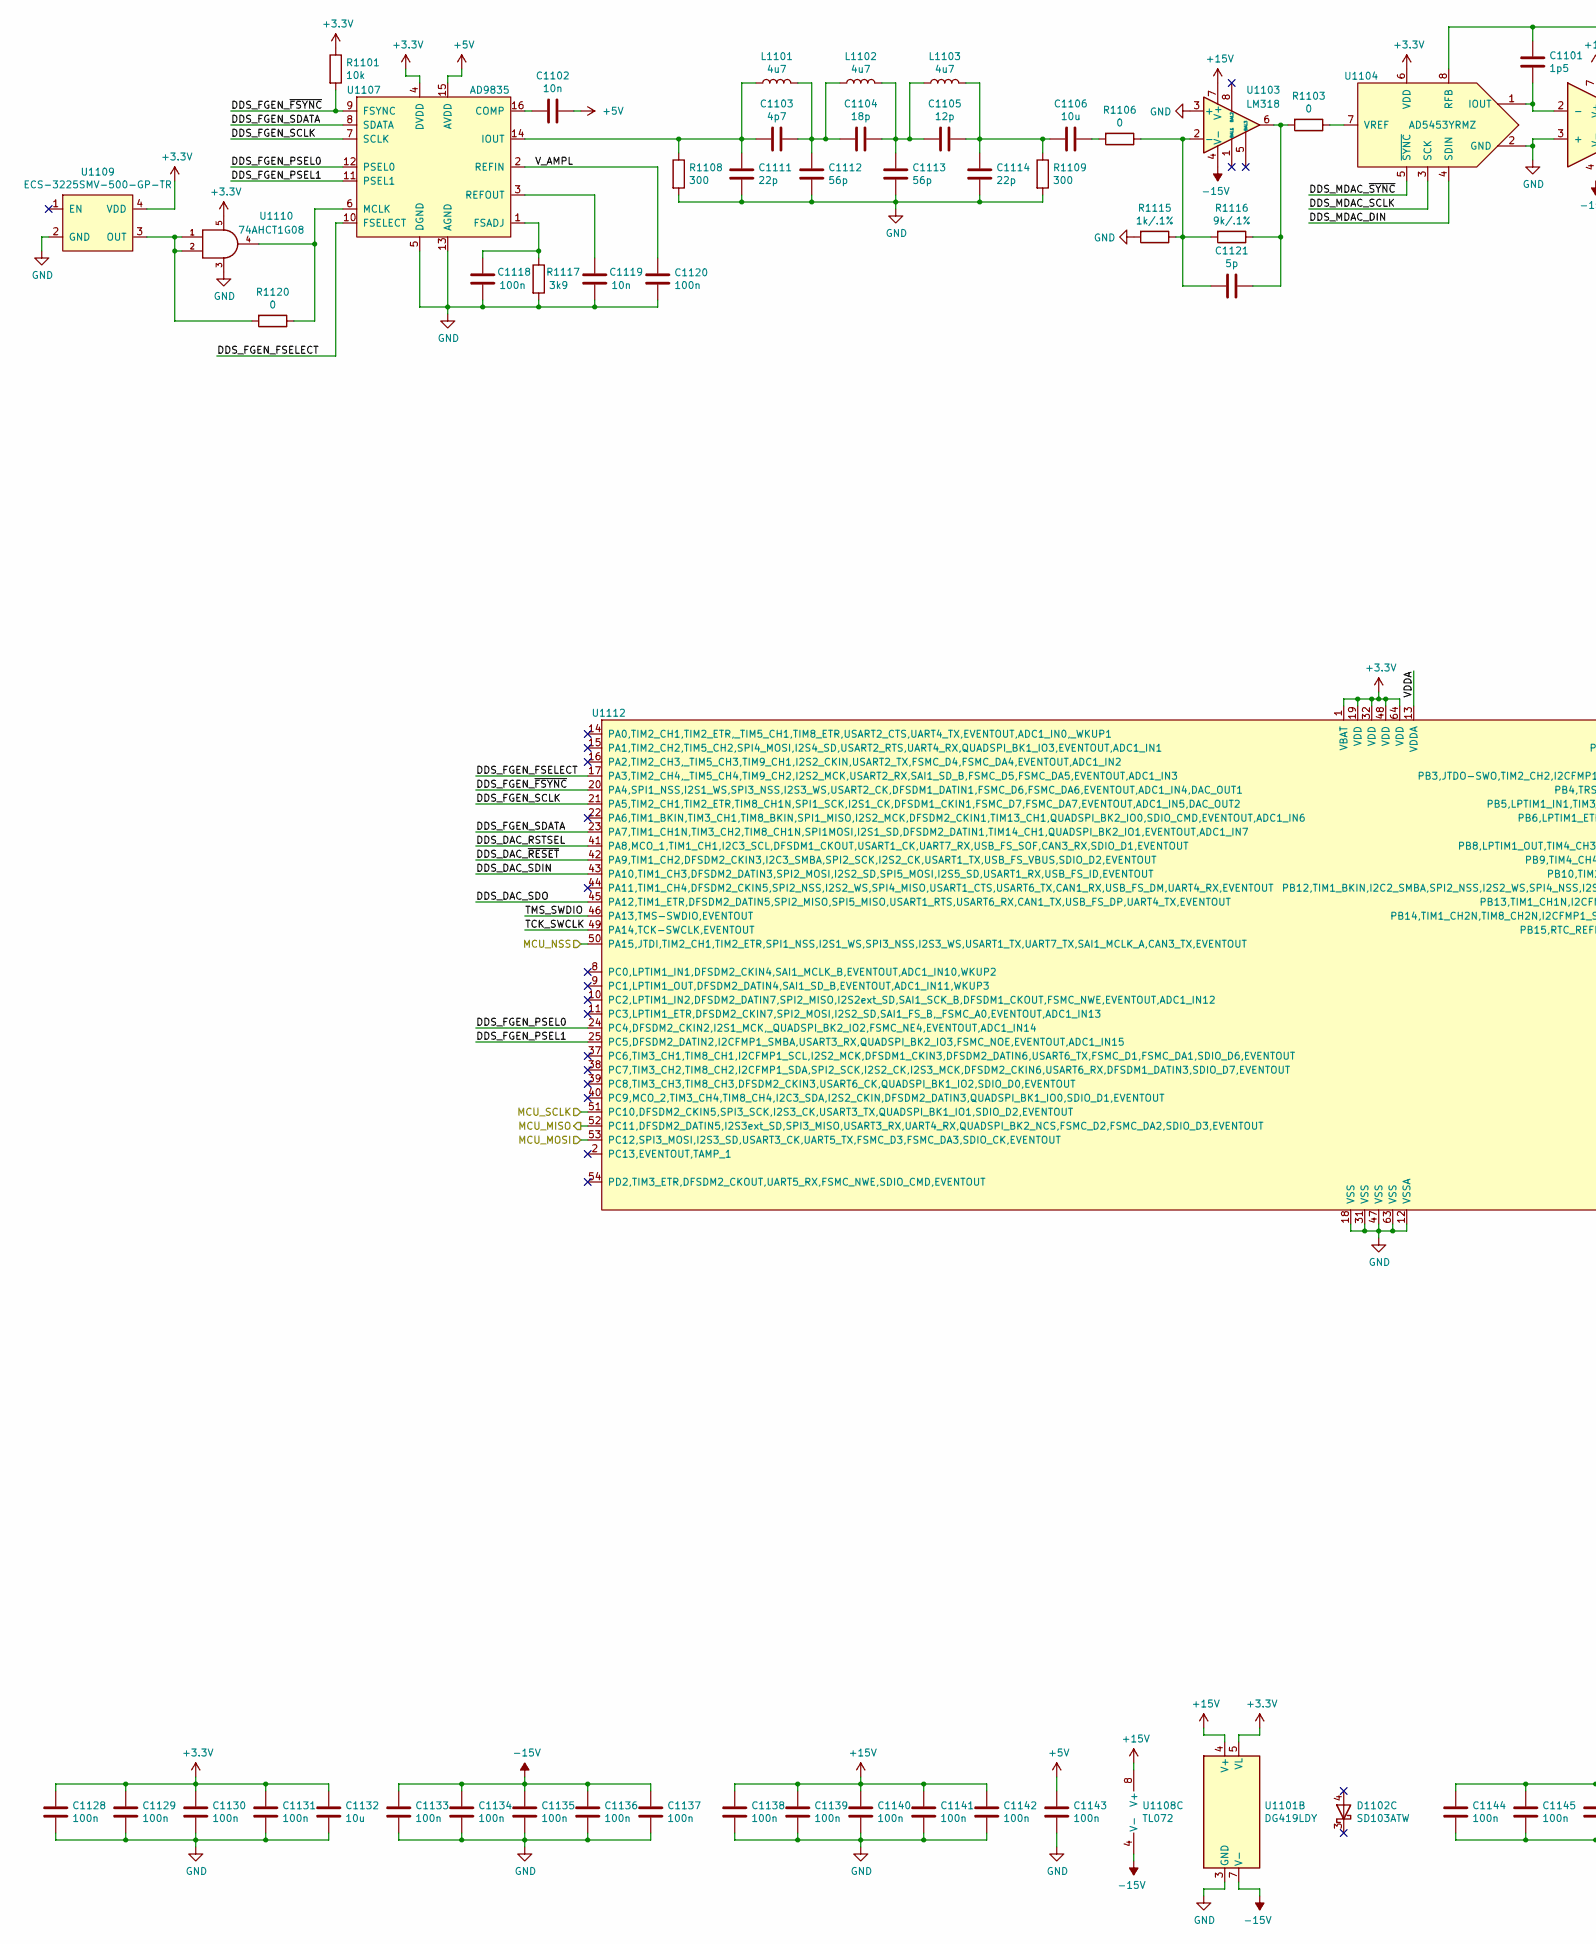
[picture p19: schematic FGEN.sch, Function generator, part in row 1, column 1]

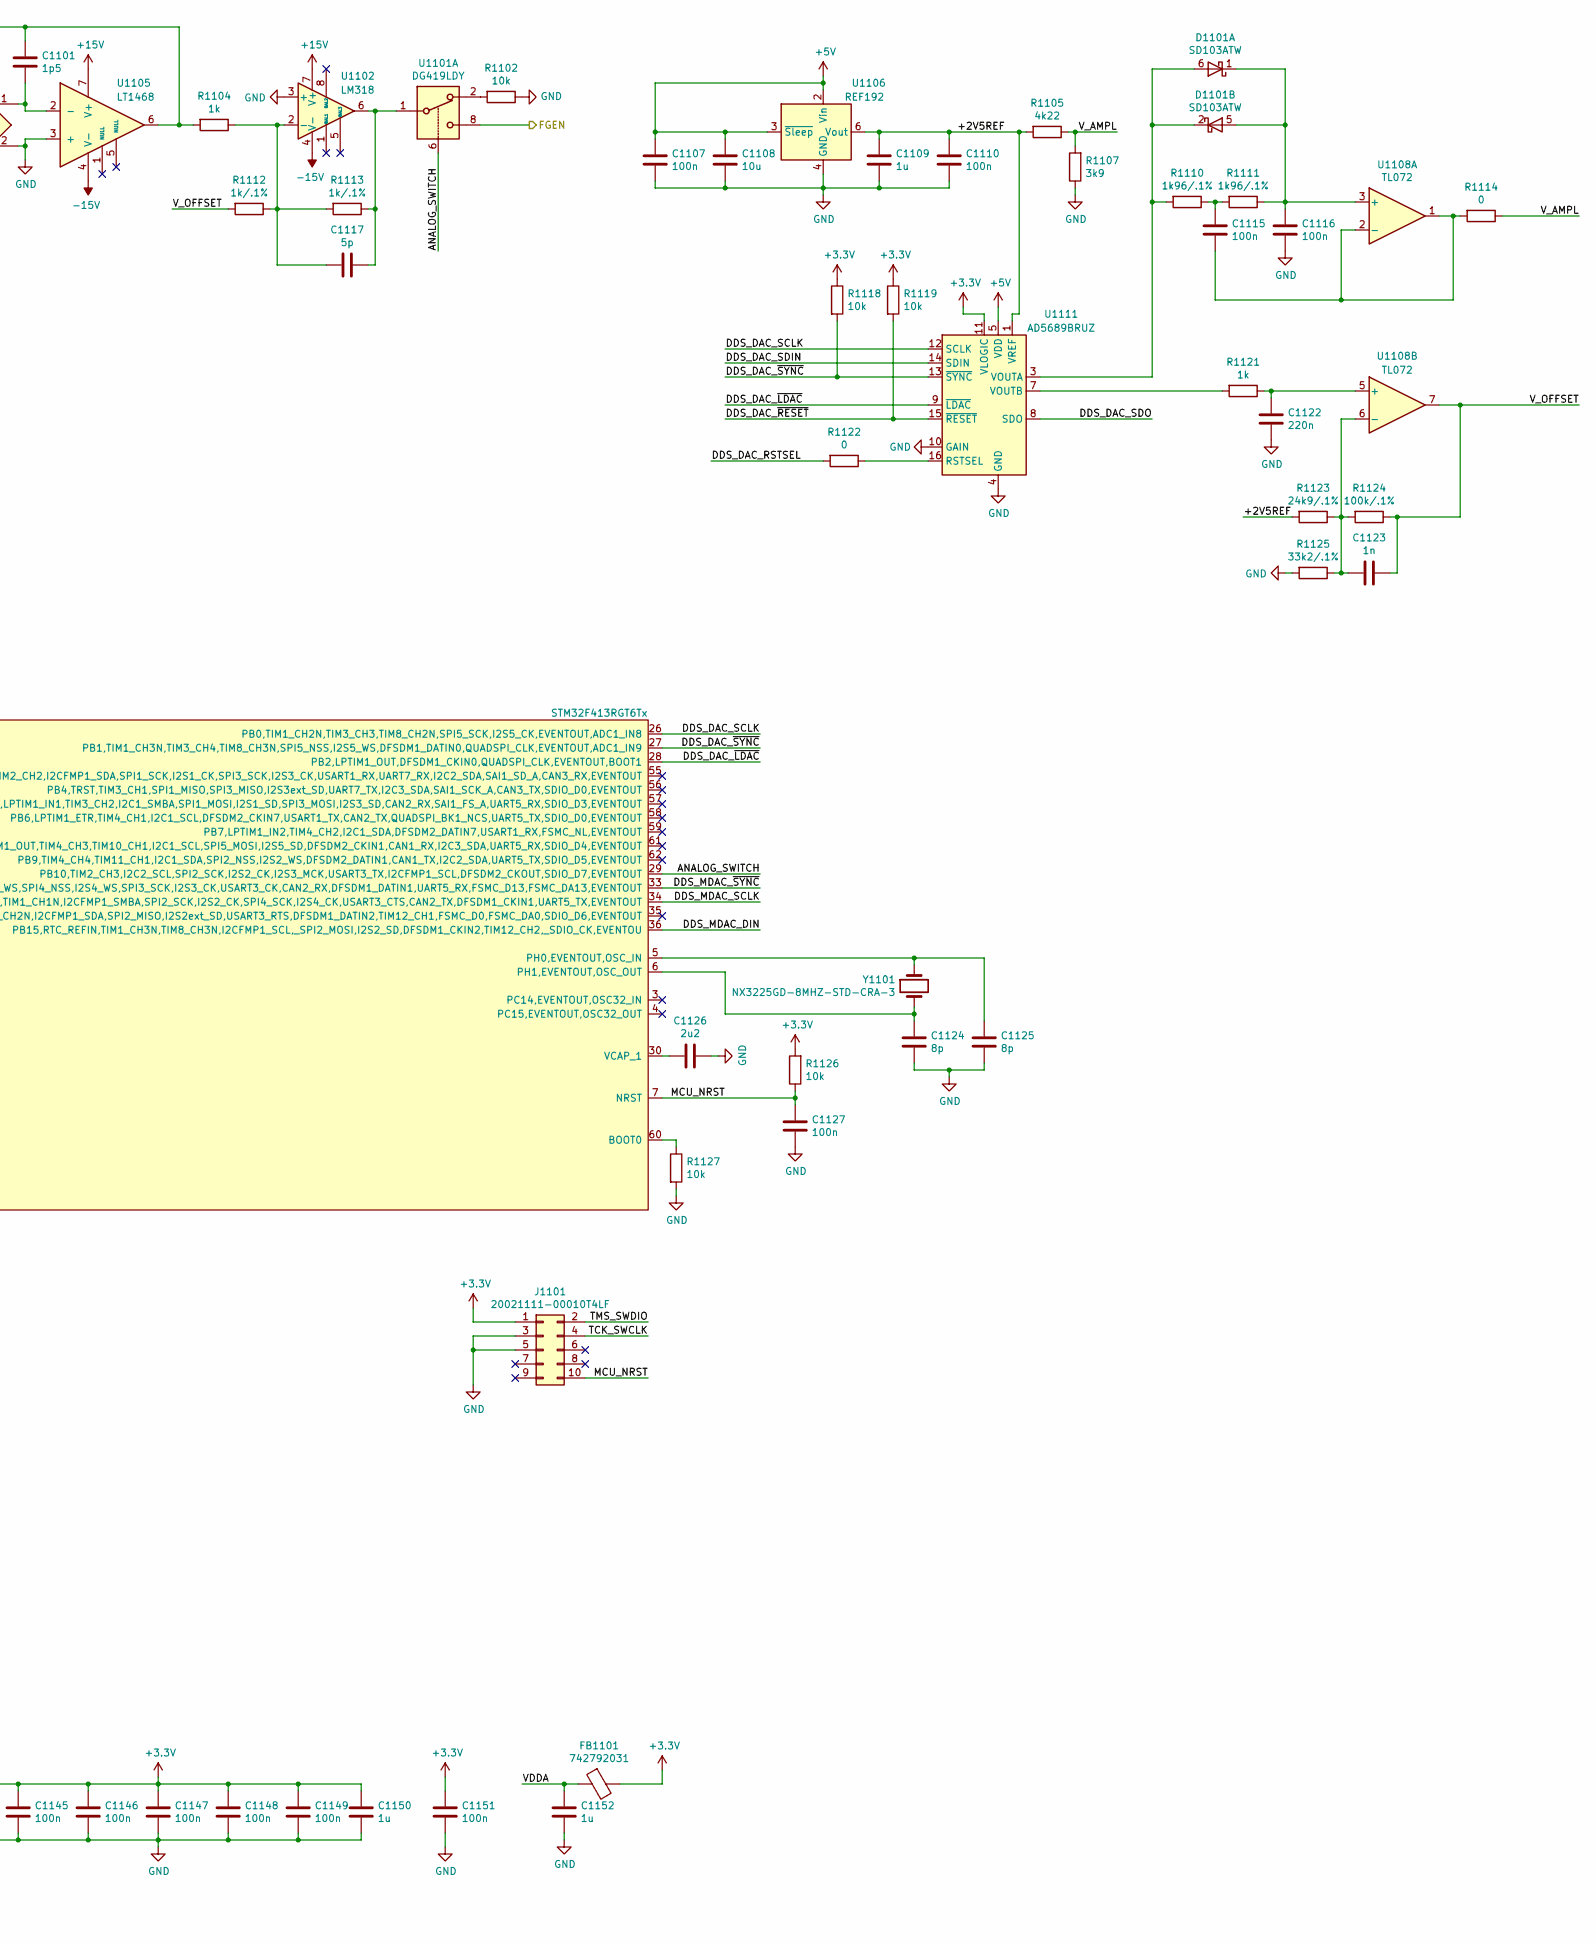
[picture p20: schematic FGEN.sch, Function generator, part in row 1, column 2]

Parts:
C1101: 1p5; C_0603_1608Metric_Pad1.08x0.95mm_HandSolder
C1102, C1119: 10n; C_0603_1608Metric_Pad1.08x0.95mm_HandSolder
C1103: 4p7; C_0603_1608Metric_Pad1.08x0.95mm_HandSolder
C1104: 18p; C_0603_1608Metric_Pad1.08x0.95mm_HandSolder
C1105: 12p; C_0603_1608Metric_Pad1.08x0.95mm_HandSolder
C1106: 10u; C_1206_3216Metric_Pad1.33x1.80mm_HandSolder
C1107, C1110, C1115, C1116, C1118, C1120, C1127, C1128, C1129, C1130, C1131, C1133, C1134, C1135, C1136, C1137, C1138, C1139, C1140, C1141, C1142, C1143, C1144, C1145, C1146, C1147, C1148, C1149, C1151: 100n; C_0603_1608Metric_Pad1.08x0.95mm_HandSolder
C1108, C1132: 10u; C_0805_2012Metric_Pad1.18x1.45mm_HandSolder
C1109, C1150, C1152: 1u; C_0603_1608Metric_Pad1.08x0.95mm_HandSolder
C1111, C1114: 22p; C_0603_1608Metric_Pad1.08x0.95mm_HandSolder
C1112, C1113: 56p; C_0603_1608Metric_Pad1.08x0.95mm_HandSolder
C1117, C1121: 5p; C_0603_1608Metric_Pad1.08x0.95mm_HandSolder
C1122: 220n; C_0603_1608Metric_Pad1.08x0.95mm_HandSolder
C1123: 1n; C_0603_1608Metric_Pad1.08x0.95mm_HandSolder
C1124, C1125: 8p; C_0603_1608Metric_Pad1.08x0.95mm_HandSolder
C1126: 2u2; C_0603_1608Metric_Pad1.08x0.95mm_HandSolder
D1101, D1102: SD103ATW; SOT-363_SC-70-6
FB1101: 742792031; L_0805_2012Metric_Pad1.15x1.40mm_HandSolder
J1101: 20021111-00010T4LF; PinHeader_2x05_P1.27mm_Vertical
L1101, L1102, L1103: 4u7; L_0603_1608Metric_Pad1.05x0.95mm_HandSolder
R1101, R1102, R1118, R1119, R1126, R1127: 10k; R_0603_1608Metric_Pad0.98x0.95mm_HandSolder
R1103, R1106, R1114, R1120, R1122: 0; R_0603_1608Metric_Pad0.98x0.95mm_HandSolder
R1104, R1121: 1k; R_0603_1608Metric_Pad0.98x0.95mm_HandSolder
R1105: 4k22; R_0603_1608Metric_Pad0.98x0.95mm_HandSolder
R1107, R1117: 3k9; R_0603_1608Metric_Pad0.98x0.95mm_HandSolder
R1108, R1109: 300; R_0603_1608Metric_Pad0.98x0.95mm_HandSolder
R1110, R1111: 1k96/.1%; R_0603_1608Metric_Pad0.98x0.95mm_HandSolder
R1112, R1113, R1115: 1k/.1%; R_0805_2012Metric_Pad1.20x1.40mm_HandSolder
R1116: 9k/.1%; R_0805_2012Metric_Pad1.20x1.40mm_HandSolder
R1123: 24k9/.1%; R_0603_1608Metric_Pad0.98x0.95mm_HandSolder
R1124: 100k/.1%; R_0603_1608Metric_Pad0.98x0.95mm_HandSolder
R1125: 33k2/.1%; R_0603_1608Metric_Pad0.98x0.95mm_HandSolder
U1101: DG419LDY; SOIC-8_3.9x4.9mm_P1.27mm
U1102, U1103: LM318; SOIC-8_3.9x4.9mm_P1.27mm
U1104: AD5453YRMZ; MSOP-8_3x3mm_P0.65mm
U1105: LT1468; SSOP-8_3.9x5.05mm_P1.27mm
U1106: REF192; SSOP-8_3.9x5.05mm_P1.27mm
U1107: AD9835; TSSOP-16_4.4x5mm_P0.65mm
U1108: TL072; SOIC-8_3.9x4.9mm_P1.27mm
U1109: ECS-3225SMV-500-GP-TR; ECS
U1110: 74AHCT1G08; SOT-353_SC-70-5
U1111: AD5689BRUZ; TSSOP-16_4.4x5mm_P0.65mm
U1112: STM32F413RGT6Tx; LQFP-64_10x10mm_P0.5mm
Y1101: NX3225GD-8MHZ-STD-CRA-3; NX3225GD

Connections:
+3V3: C1128.1, C1129.1, C1130.1, C1131.1, C1132.1, C1144.1, C1145.1, C1146.1, C1147.1, C1148.1, C1149.1, C1150.1, C1151.1, FB1101.2, J1101.1, R1101.1, R1118.1, R1119.1, R1126.2, U1101.5 (VL), U1104.6 (VDD), U1107.4 (DVDD), U1109.4 (VDD), U1110.5, U1111.11 (VLOGIC), U1112.1 (VBAT), U1112.19 (VDD), U1112.32 (VDD), U1112.48 (VDD), U1112.64 (VDD); also elsewhere on the board
+5V: C1102.1, C1107.1, C1108.1, C1143.1, U1106.2 (Vin), U1106.3 (~Sleep~), U1107.15 (AVDD), U1111.5 (VDD); also elsewhere on the board
+15V: C1138.1, C1139.1, C1140.1, C1141.1, C1142.1, U1101.4 (V+), U1102.7 (V+), U1103.7 (V+), U1105.7 (V+), U1108.8 (V+); also elsewhere on the board
-15V: C1133.1, C1134.1, C1135.1, C1136.1, C1137.1, U1101.7 (V-), U1102.4 (V-), U1103.4 (V-), U1105.4 (V-), U1108.4 (V-); also elsewhere on the board
/Control/FGEN: U1101.8; also elsewhere on the board
/Function generator/+2V5REF: C1109.1, C1110.1, R1105.2, R1123.2, U1106.6 (Vout), U1111.1 (VREF)
/Function generator/ANALOG_SWITCH: U1101.6, U1112.29 (PB10,TIM2_CH3,I2C2_SCL,SPI2_SCK,I2S2_CK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)
/Function generator/DDS_DAC_RSTSEL: R1122.2, U1112.41 (PA8,MCO_1,TIM1_CH1,I2C3_SCL,DFSDM1_CKOU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)
/Function generator/DDS_DAC_SCLK: U1111.12 (SCLK), U1112.26 (PB0,TIM1_CH2N,TIM3_CH3,TIM8_CH2N,SPI5_S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)
/Function generator/DDS_DAC_SDIN: U1111.14 (SDIN), U1112.43 (PA10,TIM1_CH3,DFSDM2_DATIN3,SPI2_MOSI,I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)
/Function generator/DDS_DAC_SDO: U1111.8 (SDO), U1112.45 (PA12,TIM1_ETR,DFSDM2_DATIN5,SPI2_MISO,S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)
/Function generator/DDS_DAC_~LDAC: U1111.9 (~LDAC), U1112.28 (PB2,LPTIM1_OUT,DFSDM1_CKIN0,QUADSPI_CLK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)
/Function generator/DDS_DAC_~RESET: R1119.2, U1111.15 (~RESET), U1112.42 (PA9,TIM1_CH2,DFSDM2_CKIN3,I2C3_SMBA,SPI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)
/Function generator/DDS_DAC_~SYNC: R1118.2, U1111.13 (~SYNC), U1112.27 (PB1,TIM1_CH3N,TIM3_CH4,TIM8_CH3N,SPI5_N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)
/Function generator/DDS_FGEN_FSELECT: U1107.10 (FSELECT), U1112.17 (PA3,TIM2_CH4,_TIM5_CH4,TIM9_CH2,I2S2_MC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)
/Function generator/DDS_FGEN_PSEL0: U1107.12 (PSEL0), U1112.24 (PC4,DFSDM2_CKIN2,I2S1_MCK,_QUADSPI_BK2_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)
/Function generator/DDS_FGEN_PSEL1: U1107.11 (PSEL1), U1112.25 (PC5,DFSDM2_DATIN2,I2CFMP1_SMBA,USART3_R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)
/Function generator/DDS_FGEN_SCLK: U1107.7 (SCLK), U1112.21 (PA5,TIM2_CH1,TIM2_ETR,TIM8_CH1N,SPI1_SC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)
/Function generator/DDS_FGEN_SDATA: U1107.8 (SDATA), U1112.23 (PA7,TIM1_CH1N,TIM3_CH2,TIM8_CH1N,SPI1MO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)
/Function generator/DDS_FGEN_~FSYNC: R1101.2, U1107.9 (FSYNC), U1112.20 (PA4,SPI1_NSS,I2S1_WS,SPI3_NSS,I2S3_WS,U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)
/Function generator/DDS_MDAC_DIN: U1104.4 (SDIN), U1112.36 (PB15,RTC_REFIN,TIM1_CH3N,TIM8_CH3N,I2CF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)
/Function generator/DDS_MDAC_SCLK: U1104.3 (SCK), U1112.34 (PB13,TIM1_CH1N,I2CFMP1_SMBA,SPI2_SCK,I2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)
/Function generator/DDS_MDAC_~SYNC: U1104.5 (~SYNC), U1112.33 (PB12,TIM1_BKIN,I2C2_SMBA,SPI2_NSS,I2S2_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)
/Function generator/MCU_MISO: U1112.52 (PC11,DFSDM2_DATIN5,I2S3ext_SD,SPI3_MISO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); also elsewhere on the board
/Function generator/MCU_MOSI: U1112.53 (PC12,SPI3_MOSI,I2S3_SD,USART3_CK,UART5_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); also elsewhere on the board
/Function generator/MCU_NRST: C1127.1, J1101.10, R1126.1, U1112.7 (NRST)
/Function generator/MCU_NSS: U1112.50 (PA15,JTDI,TIM2_CH1,TIM2_ETR,SPI1_NSS,I2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); also elsewhere on the board
/Function generator/MCU_SCLK: U1112.51 (PC10,DFSDM2_CKIN5,SPI3_SCK,I2S3_CK,USAR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); also elsewhere on the board
/Function generator/TCK_SWCLK: J1101.4, U1112.49 (PA14,TCK-SWCLK,EVENTOUT)
/Function generator/TMS_SWDIO: J1101.2, U1112.46 (PA13,TMS-SWDIO,EVENTOUT)
/Function generator/VDDA: C1152.1, FB1101.1, U1112.13 (VDDA)
/Function generator/V_AMPL: C1120.1, R1105.1, R1107.2, R1114.1, U1107.2 (REFIN)
/Function generator/V_OFFSET: C1123.1, R1112.2, R1124.1, U1108.7
GND: C1107.2, C1108.2, C1109.2, C1110.2, C1111.2, C1112.2, C1113.2, C1114.2, C1116.1, C1118.2, C1119.2, C1120.2, C1122.2, C1124.2, C1125.2, C1126.1, C1127.2, C1128.2, C1129.2, C1130.2, C1131.2, C1132.2, C1133.2, C1134.2, C1135.2, C1136.2, C1137.2, C1138.2, C1139.2, C1140.2, C1141.2, C1142.2, C1143.2, C1144.2, C1145.2, C1146.2, C1147.2, C1148.2, C1149.2, C1150.2, C1151.2, C1152.2, J1101.3, J1101.5, R1102.1, R1107.1, R1108.2, R1109.2, R1115.2, R1117.2, R1125.2, R1127.2, U1101.3 (GND), U1102.3 (+), U1103.3 (+), U1104.2 (GND), U1105.3 (+), U1106.4 (GND), U1107.5 (DGND), U1107.13 (AGND), U1109.2 (GND), U1110.3, U1111.4 (GND), U1111.10 (GAIN), U1112.12 (VSSA), U1112.18 (VSS), U1112.31 (VSS), U1112.47 (VSS), U1112.63 (VSS); also elsewhere on the board
unnamed: C1101.1, R1104.2, U1104.8 (RFB), U1105.6
unnamed: C1101.2, U1104.1 (IOUT), U1105.2 (-)
unnamed: C1102.2, U1107.16 (COMP)
unnamed: C1103.1, C1104.2, C1112.1, L1101.2, L1102.1
unnamed: C1103.2, C1111.1, L1101.1, R1108.1, U1107.14 (IOUT)
unnamed: C1104.1, C1105.2, C1113.1, L1102.2, L1103.1
unnamed: C1105.1, C1106.2, C1114.1, L1103.2, R1109.1
unnamed: C1106.1, R1106.2
unnamed: C1115.1, R1114.2, U1108.1, U1108.2 (-)
unnamed: C1115.2, R1110.1, R1111.2
unnamed: C1116.2, D1101.1 (K), D1101.5 (A), R1111.1, U1108.3 (+)
unnamed: C1117.1, R1113.1, U1101.1, U1102.6
unnamed: C1117.2, R1104.1, R1112.1, R1113.2, U1102.2 (-)
unnamed: C1118.1, R1117.1, U1107.1 (FSADJ)
unnamed: C1119.1, U1107.3 (REFOUT)
unnamed: C1121.1, R1103.2, R1116.1, U1103.6
unnamed: C1121.2, R1106.1, R1115.1, R1116.2, U1103.2 (-)
unnamed: C1122.1, R1121.1, U1108.5 (+)
unnamed: C1123.2, R1123.1, R1124.2, R1125.1, U1108.6 (-)
unnamed: C1124.1, U1112.6 (PH1,EVENTOUT,OSC_OUT), Y1101.2
unnamed: C1125.1, U1112.5 (PH0,EVENTOUT,OSC_IN), Y1101.1
unnamed: C1126.2, U1112.30 (VCAP_1)
unnamed: D1101.2 (K), D1101.6 (A), R1110.2, U1111.3 (VOUTA)
unnamed: R1102.2, U1101.2
unnamed: R1103.1, U1104.7 (VREF)
unnamed: R1120.1, U1107.6 (MCLK), U1110.4
unnamed: R1120.2, U1109.3 (OUT), U1110.1, U1110.2
unnamed: R1121.2, U1111.7 (VOUTB)
unnamed: R1122.1, U1111.16 (RSTSEL)
unnamed: R1127.1, U1112.60 (BOOT0)

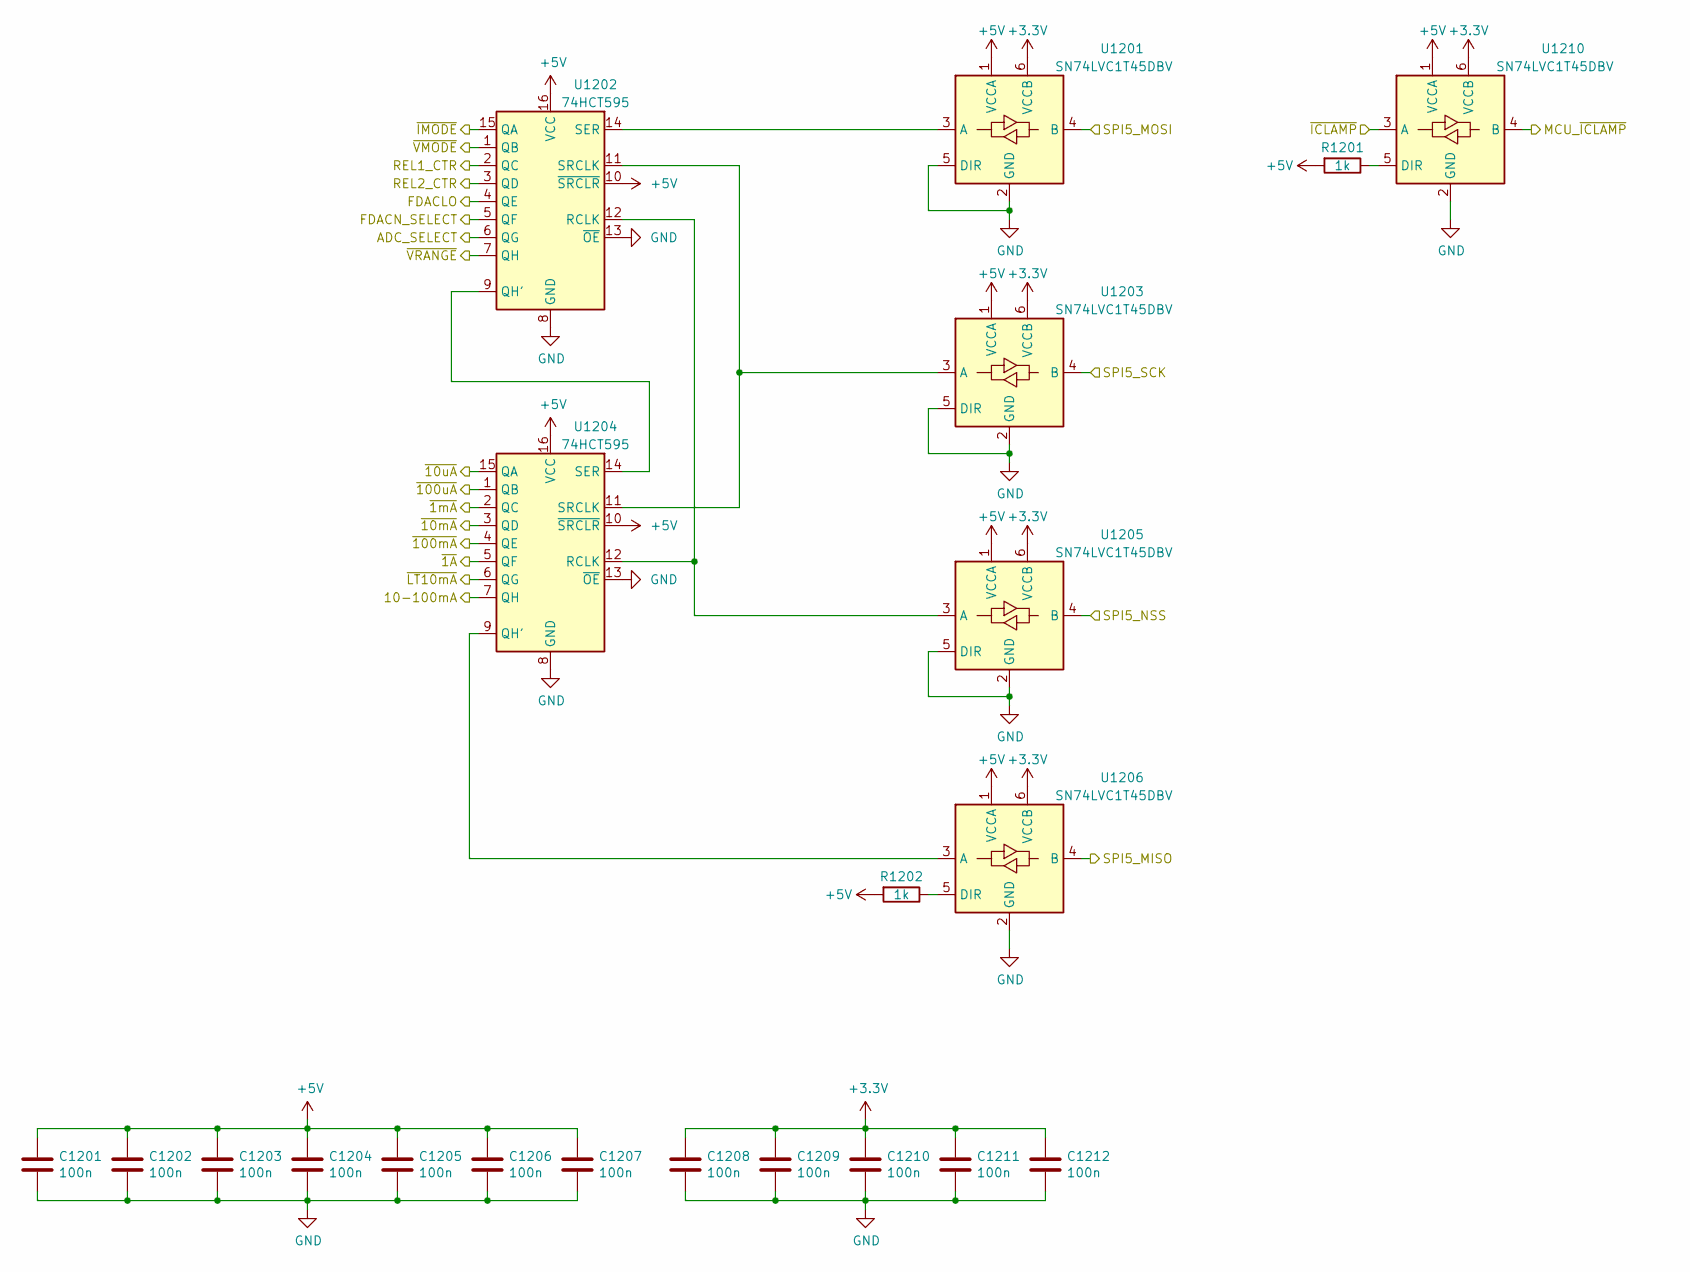
[picture p21: schematic GPIO.sch]

Parts:
C1201, C1202, C1203, C1204, C1205, C1206, C1207, C1208, C1209, C1210, C1211, C1212: 100n; C_0603_1608Metric_Pad1.08x0.95mm_HandSolder
R1201, R1202: 1k; R_0603_1608Metric_Pad0.98x0.95mm_HandSolder
U1201, U1203, U1205, U1206, U1210: SN74LVC1T45DBV; SOT-23-6
U1202, U1204: 74HCT595; TSSOP-16_4.4x5mm_P0.65mm

Connections:
+3V3: C1208.1, C1209.1, C1210.1, C1211.1, C1212.1, U1201.6 (VCCB), U1203.6 (VCCB), U1205.6 (VCCB), U1206.6 (VCCB), U1210.6 (VCCB); also elsewhere on the board
+5V: C1201.1, C1202.1, C1203.1, C1204.1, C1205.1, C1206.1, C1207.1, R1201.2, R1202.2, U1201.1 (VCCA), U1202.10 (~SRCLR), U1202.16 (VCC), U1203.1 (VCCA), U1204.10 (~SRCLR), U1204.16 (VCC), U1205.1 (VCCA), U1206.1 (VCCA), U1210.1 (VCCA); also elsewhere on the board
/Analog/10-100mA: U1204.7 (QH); also elsewhere on the board
/Analog/REL1_CTR: U1202.2 (QC); also elsewhere on the board
/Analog/REL2_CTR: U1202.3 (QD); also elsewhere on the board
/Analog/~1A: U1204.5 (QF); also elsewhere on the board
/Analog/~1mA: U1204.2 (QC); also elsewhere on the board
/Analog/~10mA: U1204.3 (QD); also elsewhere on the board
/Analog/~10uA: U1204.15 (QA); also elsewhere on the board
/Analog/~100mA: U1204.4 (QE); also elsewhere on the board
/Analog/~100uA: U1204.1 (QB); also elsewhere on the board
/Analog/~ICLAMP: U1210.3 (A); also elsewhere on the board
/Analog/~IMODE: U1202.15 (QA); also elsewhere on the board
/Analog/~LT10mA: U1204.6 (QG); also elsewhere on the board
/Analog/~VMODE: U1202.1 (QB); also elsewhere on the board
/Analog/~VRANGE: U1202.7 (QH); also elsewhere on the board
/Control/ADC_SELECT: U1202.6 (QG); also elsewhere on the board
/Control/FDACLO: U1202.4 (QE); also elsewhere on the board
/Control/FDACN_SELECT: U1202.5 (QF); also elsewhere on the board
/GPIO/MCU_~ICLAMP: U1210.4 (B); also elsewhere on the board
/MCU/SPI1_MISO: U1206.4 (B); also elsewhere on the board
/MCU/SPI1_MOSI: U1201.4 (B); also elsewhere on the board
/MCU/SPI1_NSS: U1205.4 (B); also elsewhere on the board
/MCU/SPI1_SCK: U1203.4 (B); also elsewhere on the board
GND: C1201.2, C1202.2, C1203.2, C1204.2, C1205.2, C1206.2, C1207.2, C1208.2, C1209.2, C1210.2, C1211.2, C1212.2, U1201.2 (GND), U1201.5 (DIR), U1202.8 (GND), U1202.13 (~OE), U1203.2 (GND), U1203.5 (DIR), U1204.8 (GND), U1204.13 (~OE), U1205.2 (GND), U1205.5 (DIR), U1206.2 (GND), U1210.2 (GND); also elsewhere on the board
unnamed: R1201.1, U1210.5 (DIR)
unnamed: R1202.1, U1206.5 (DIR)
unnamed: U1201.3 (A), U1202.14 (SER)
unnamed: U1202.9 (QH'), U1204.14 (SER)
unnamed: U1202.11 (SRCLK), U1203.3 (A), U1204.11 (SRCLK)
unnamed: U1202.12 (RCLK), U1204.12 (RCLK), U1205.3 (A)
unnamed: U1204.9 (QH'), U1206.3 (A)

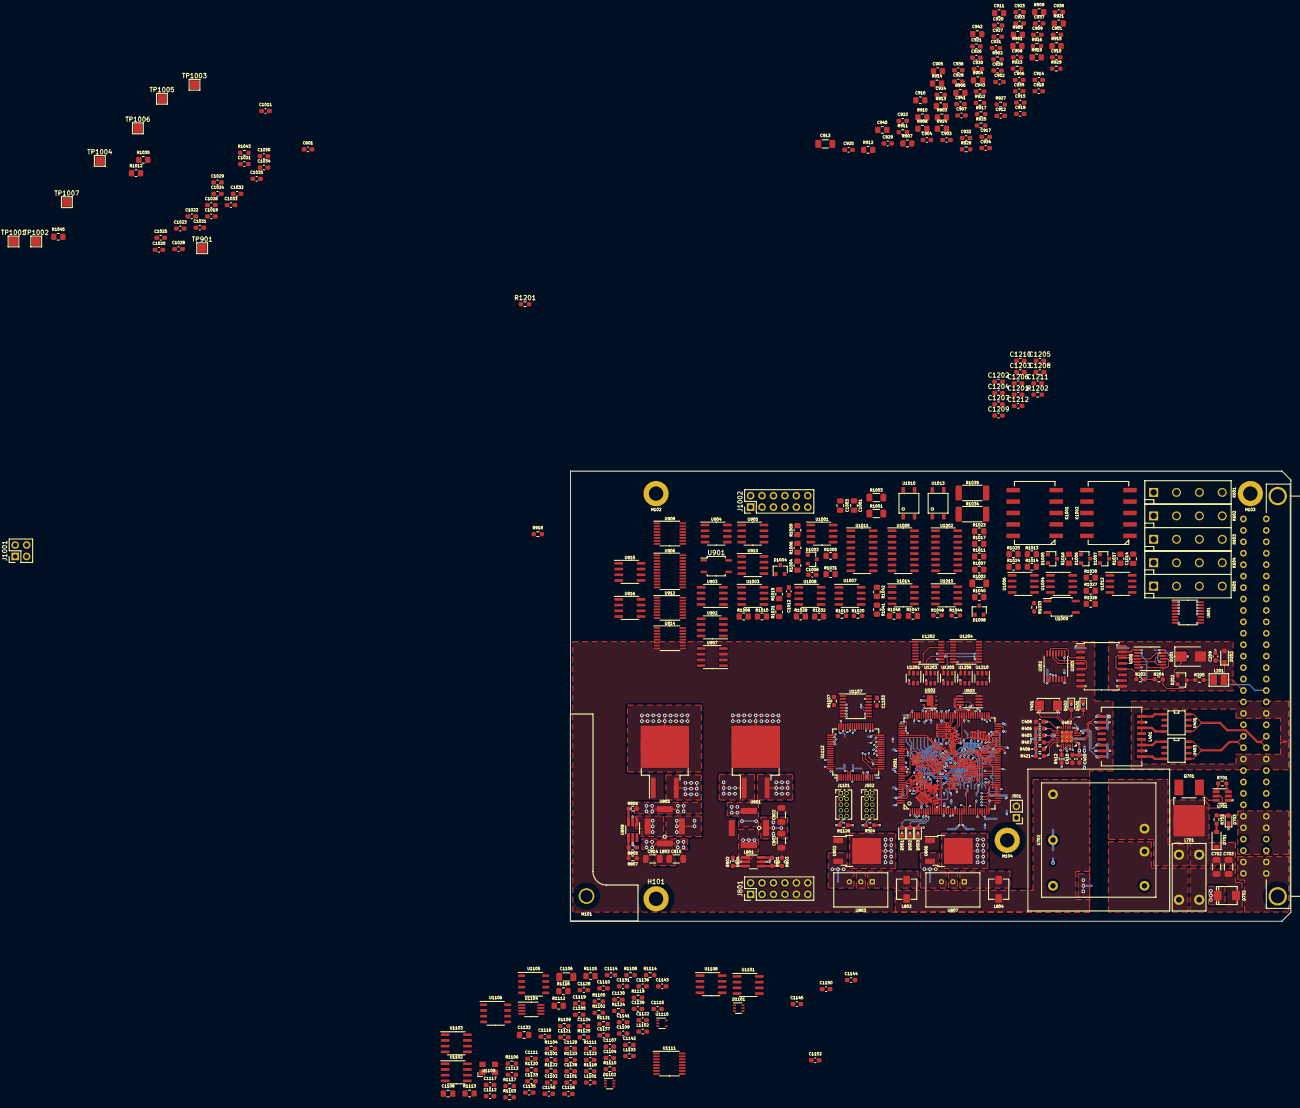
[picture p22: board BASE.kicad_pcb from above]

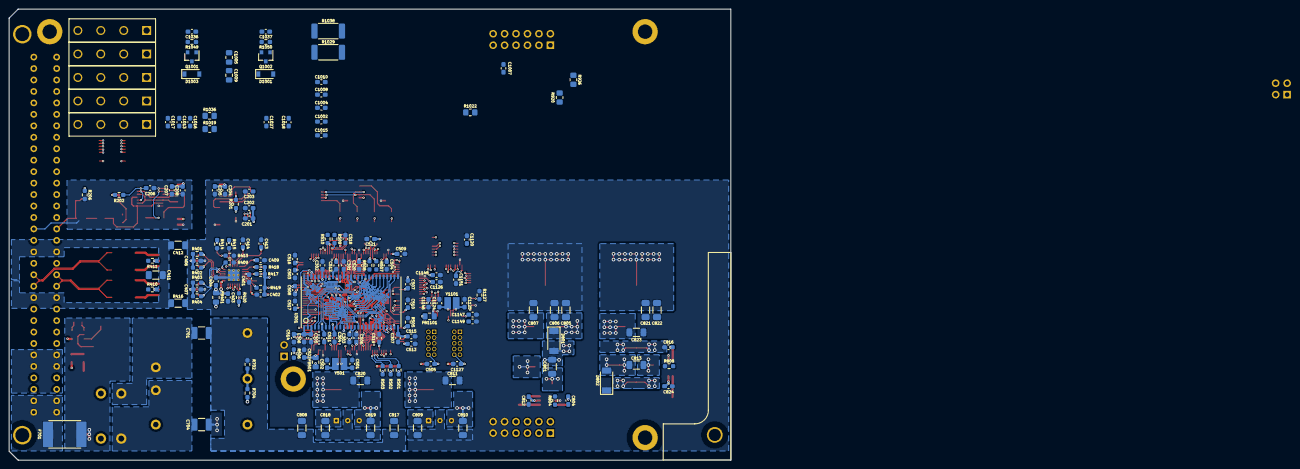
[picture p23: board BASE.kicad_pcb from below]

Board: 6 copper layers, 160.0 x 100.0 mm, 520 parts (149 on the bottom side), 372 nets.
