BehrensG/ETH1CSMU1/(commit log)

2018-11-06 Added schematic from different project
    [ADC.sch, ETH1CSMU1.kicad_pcb, ETH1CSMU1.sch, FGEN.sch, Feed-ForwardCurrentBooster.sch, Feedback.sch, MCU.sch, MCUMain.sch]
2018-11-08 Added ADC
    [CAN.sch, Connector.sch, ETH1CSMU1.sch, Ethernet.sch, FGEN.sch, Feed-ForwardCurrentBooster.sch, Feedback.sch, MCUMain.sch]
2018-11-25 Power schematic
    [ADC.sch, CAN.sch, Connector.sch, ETH1CSMU1.sch, Ethernet.sch, FGEN.sch, Feed-ForwardCurrentBooster.sch, Feedback.sch]
2018-11-29 Footprint selection
    [ADC.sch, Connector.sch, Ethernet.sch, FGEN.sch, Feed-ForwardCurrentBooster.sch, Feedback.sch, MCUMain.sch, MCUSecond.sch]
2018-12-03 Redesigned feedback circuit.
    [ADC.sch, CAN.sch, ETH1CSMU1.sch, Ethernet.sch, FGEN.sch, Feed-ForwardCurrentBooster.sch, Feedback.sch, MCUMain.sch]
2018-12-04 Added MUX schematic
    [ADC.sch, CAN.sch, Connector.sch, ETH1CSMU1.sch, Ethernet.sch, FGEN.sch, Feed-ForwardCurrentBooster.sch, Feedback.sch]
2018-12-09 Schematic development
    [ADC.sch, Address.sch, CAN.sch, Connector.sch, ETH1CSMU1.sch, Ethernet.sch, FGEN.sch, Feed-ForwardCurrentBooster.sch]
2018-12-10 Changed BUS mux schematic
    [ADC.sch, ETH1CSMU1.sch, Feedback.sch, MUX.sch, VIControl.sch]
2018-12-16 check in
    [Address.sch, CAN.sch, Connector.sch, Ethernet.sch, FGEN.sch, Feed-ForwardCurrentBooster.sch, Feedback.sch, MCUMain.sch]
2018-12-31 Added test circuits, bug fix.
    [ADC.sch, Address.sch, CAN.sch, Connector.sch, ETH1CSMU1.kicad_pcb, ETH1CSMU1.sch, Ethernet.sch, FGEN.sch]
2019-01-02 Bug fix
    [Address.sch, FGEN.sch, Power.sch, Test.sch]
2019-10-05 Layout redesign
    [AnalogControl.sch, ETH1CSMU1ANALOG.kicad_pcb, ETH1CSMU1ANALOG.sch, ETH1CSMU1BASE.kicad_pcb, ETH1CSMU1BASE.sch, MCU.sch, Power_Analog.sch, Power_Digital.sch]
2019-11-11 Base board schematic.
    [AnalogControl.sch, Connectors.sch, ETH1CSMU1ANALOG.sch, ETH1CSMU1BASE.sch, Ethernet.sch, MCU.sch, Output_Module.sch, Power.sch]
2019-11-11 Schematic developement, new footprints.
    [Connectors.sch, ETH1CSMU1BASE.sch, Ethernet.sch, MCU.sch, Power_base.sch, Power_isolation.sch, Trigger.sch]
2019-11-14 Schematic design.
    [Connectors.sch, ETH1CSMU1BASE.sch, Ethernet.sch, MCU.sch, Output_Module.sch, Power_High_Voltage.sch, Power_base.sch, Power_isolation.sch]
2020-04-04 Power supply design
    [Connectors.sch, ETH1CSMU1BASE.sch, Ethernet.sch, MCU.sch, Output_Module.sch, Power_High_Voltage.sch, Power_base.sch, Power_isolation.sch]
2020-04-04 Footprint assigment
    [ADC.sch, AnalogControl.sch, Connectors.sch, ETH1CSMU1ANALOG.sch, MCU.sch, Output_Module.sch, Power_High_Voltage.sch, Power_base.sch]
2020-04-07 Footprint assignment
    [ADC.sch, AnalogControl.sch, Connectors.sch, ETH1CSMU1ANALOG.sch, ETH1CSMU1BASE.sch, Ethernet.sch, MCU1.sch, MCU2.sch]
2021-03-14 Schematic redesign, based on http://www.djerickson.com/diy_smu/index.html
    [ADC.sch, Address.sch, BASE.kicad_pcb, BASE.sch, CAN.sch, Connector.sch, ETH1CSMU1.kicad_pcb, ETH1CSMU1.sch]
2021-03-17 Schematic design
    [BASE.sch, Connector.sch, Control.sch, Ethernet.sch, HV_Power.sch, IO_Isolation.sch, MCU.sch, Module_Connector.sch]
2021-03-22 PCB layout
    [Analog.sch, BASE.kicad_pcb, BASE.sch, Connector.sch, Control.sch, Ethernet.sch, FGEN.sch, GPIO.sch]
2021-03-28 PCB and schematic design.
    [Analog.sch, BASE.kicad_pcb, BASE.sch, Control.sch, FGEN.sch, GPIO.sch, HV_Amplifier.sch, HV_Power.sch]
2021-03-29 PCB and schematic
    [Analog.sch, BASE.kicad_pcb, BASE.sch, GPIO.sch, HV_Amplifier.sch, HV_Power.sch, MODULE.kicad_pcb]
2021-04-07 Schematic and PCB changes
    [Analog.sch, BASE.kicad_pcb, BASE.sch, Control.sch, FGEN.sch, GPIO.sch, MCU.sch, Power_Float.sch]
2021-07-18 PCB modifications
